jahaanb7/RadioTelescope/docs/gallery.md

# Rev C.2 CAD gallery

These five views are the user-supplied screenshots of the updated CAD, not photographs of a completed build. The ZIP also includes generated assembly-stage and part renders used throughout the assembly guide.

## Perspective

perspective CAD view

## Front

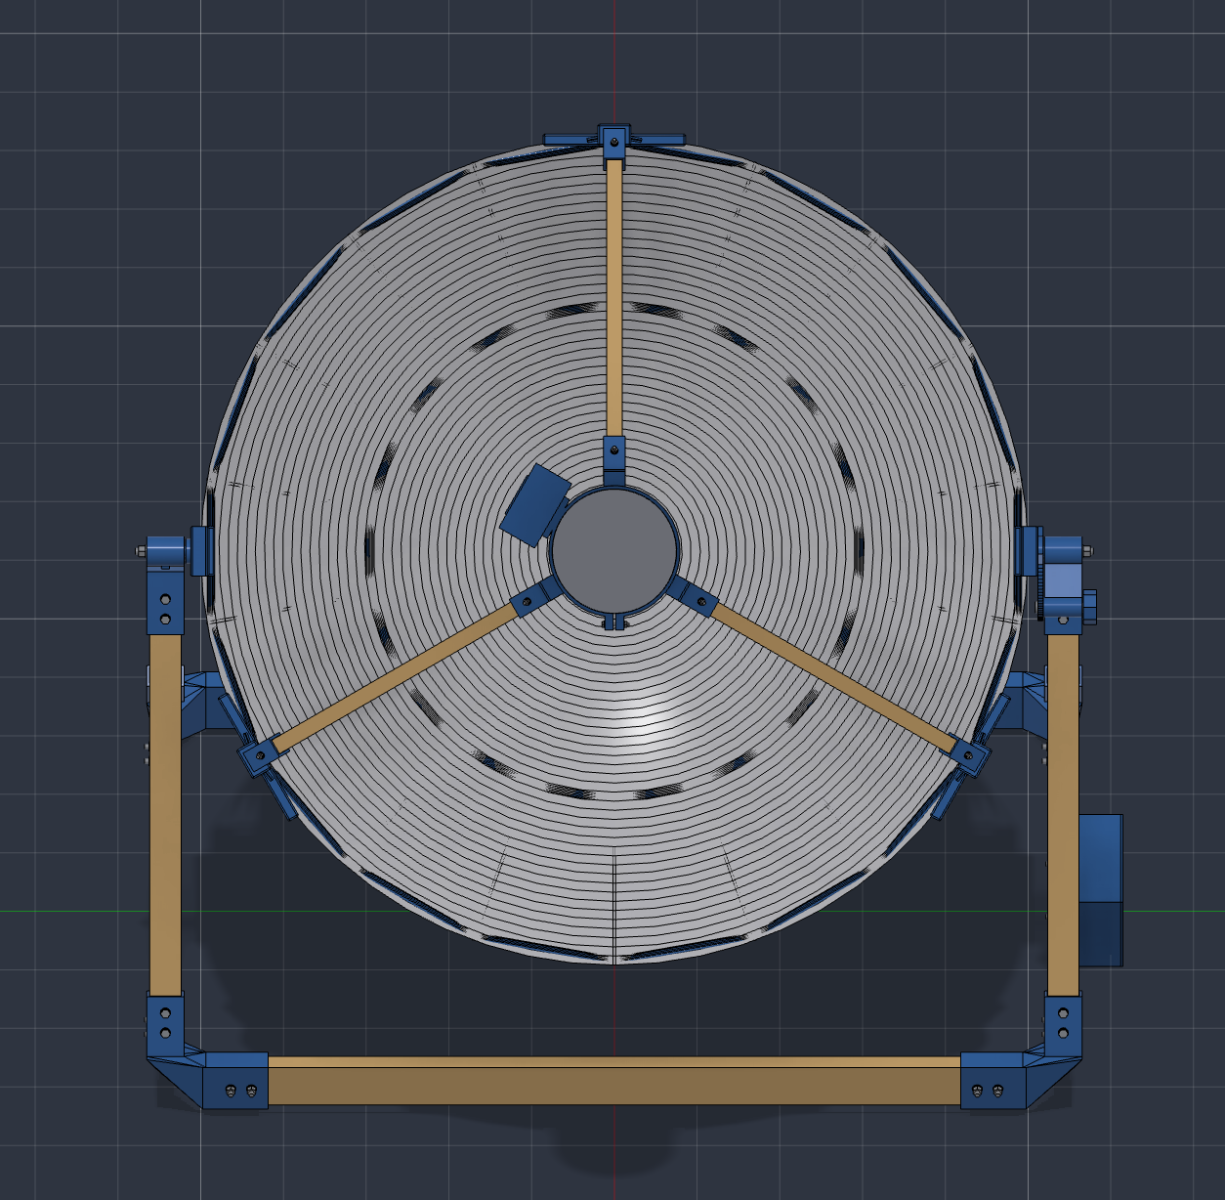
[picture p2: images/screenshots/front.png]
front CAD view


## Side

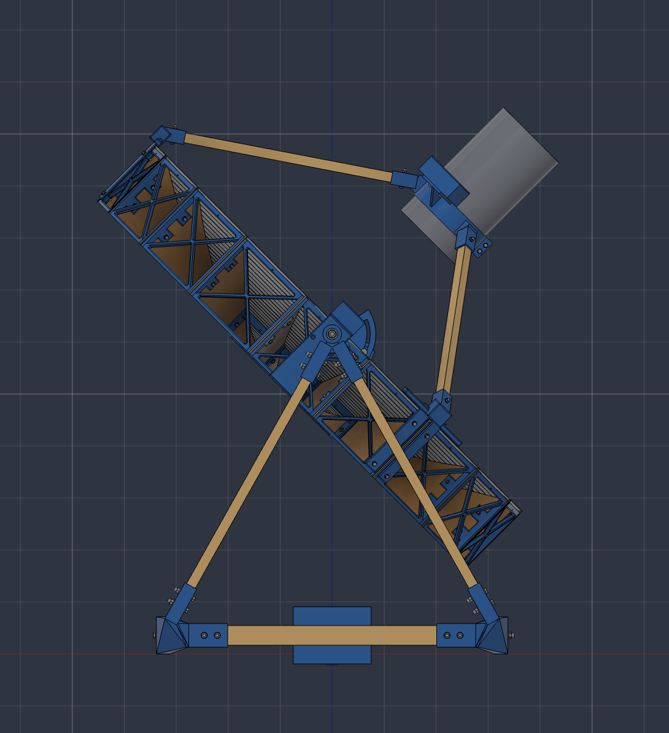
[picture p3: images/screenshots/side.png]
side CAD view


## Rear

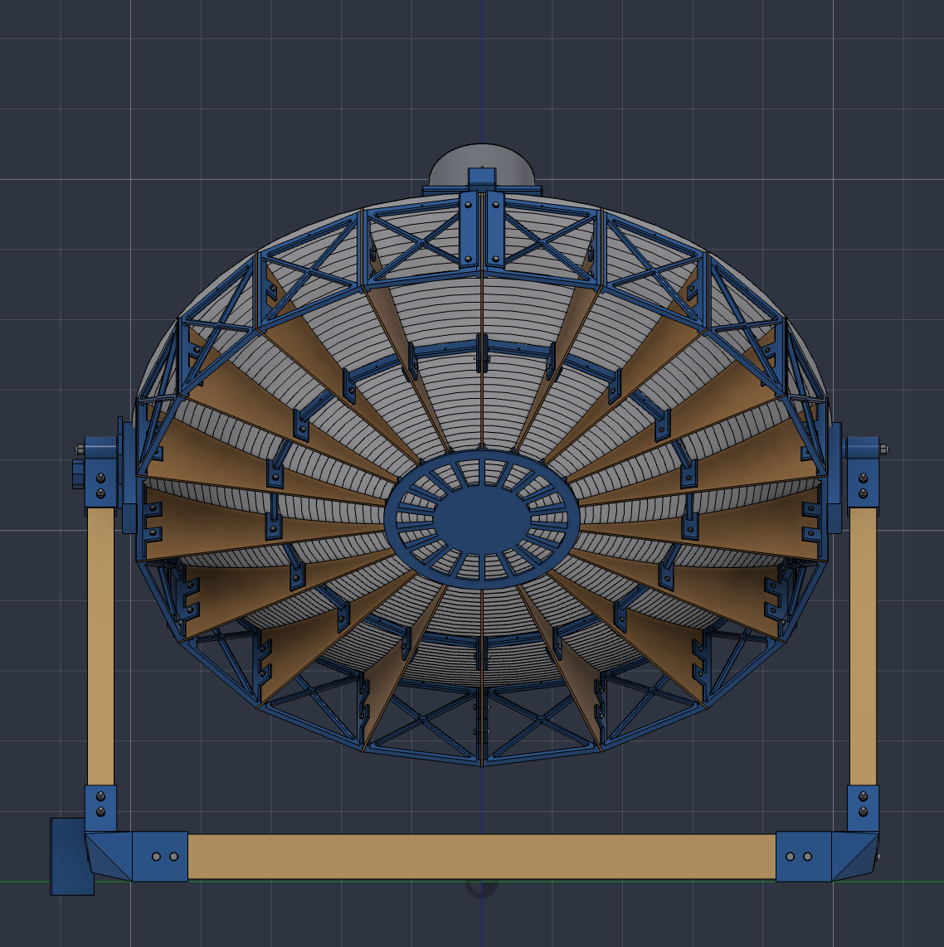
[picture p4: images/screenshots/rear.png]
rear CAD view


## Underside

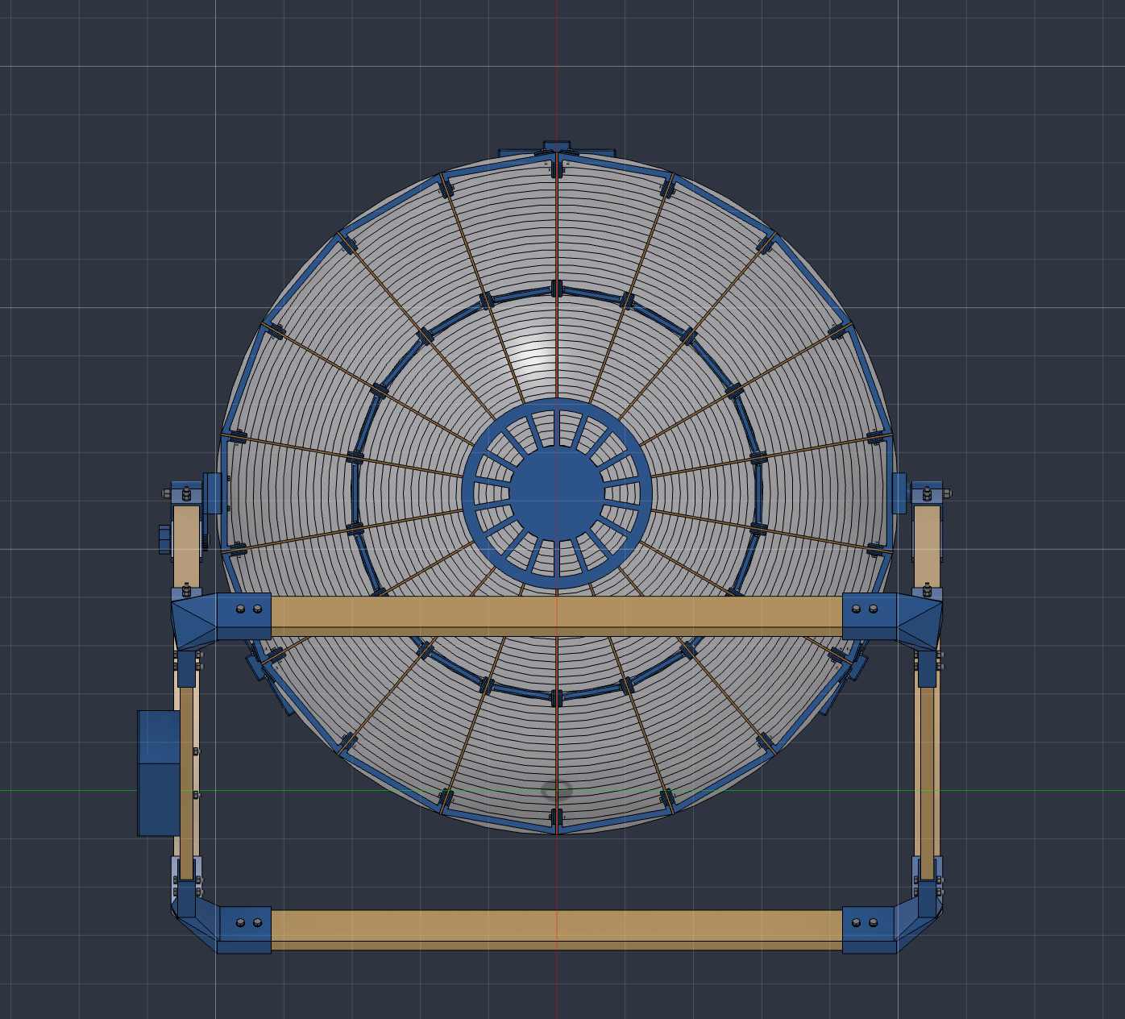
[picture p5: images/screenshots/underside.png]
underside CAD view


## Assembly stages

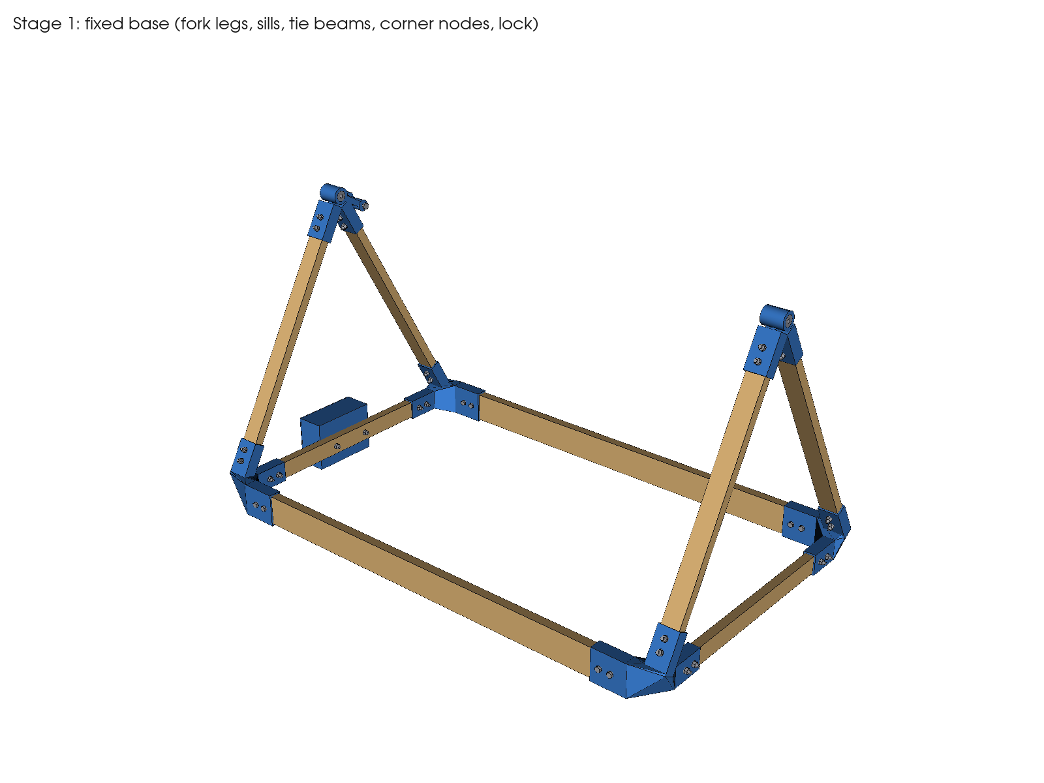
[picture p6: images/stage1_base.png]
Base and fork


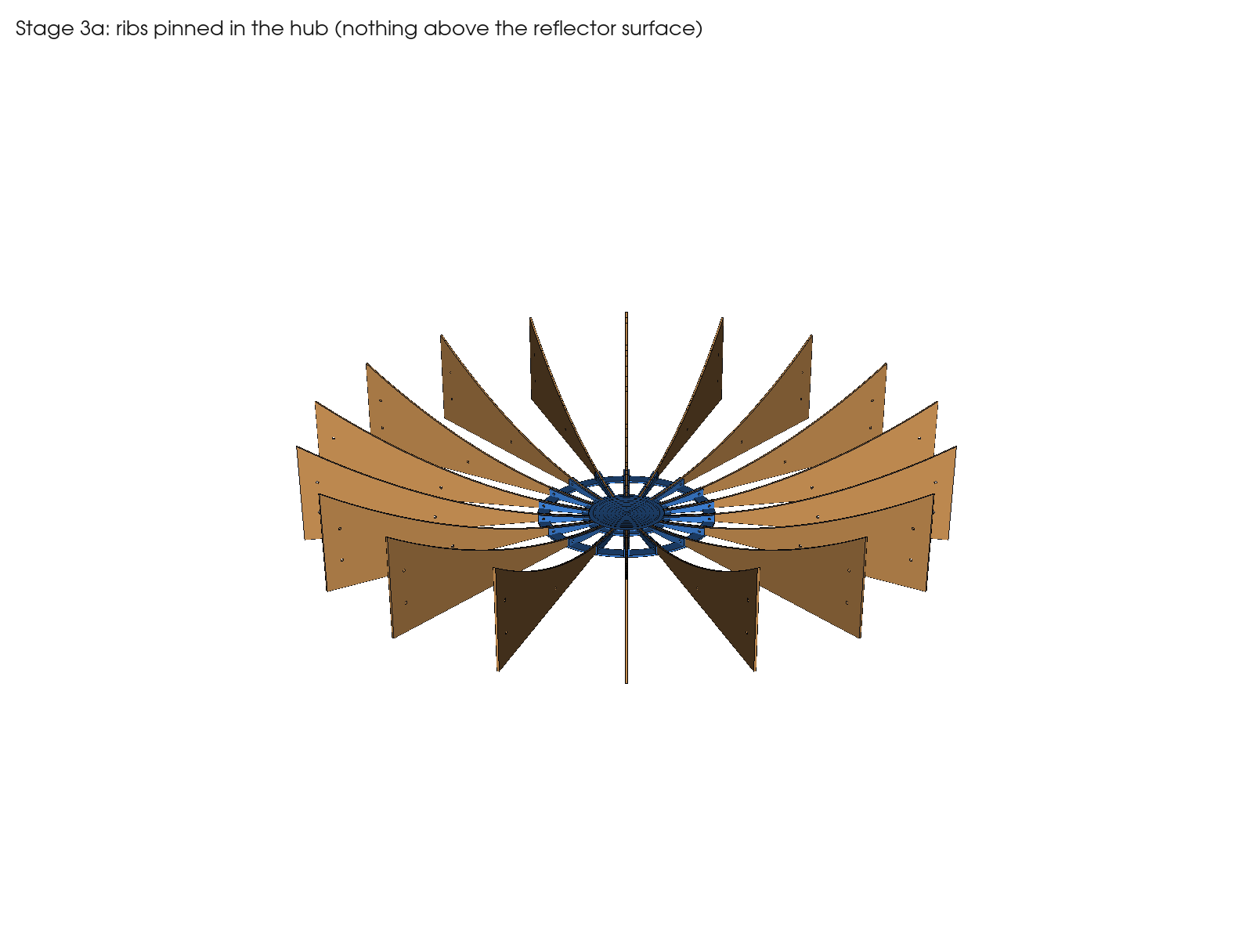
[picture p7: images/stage3a_ribs_hub.png]
Hub and ribs


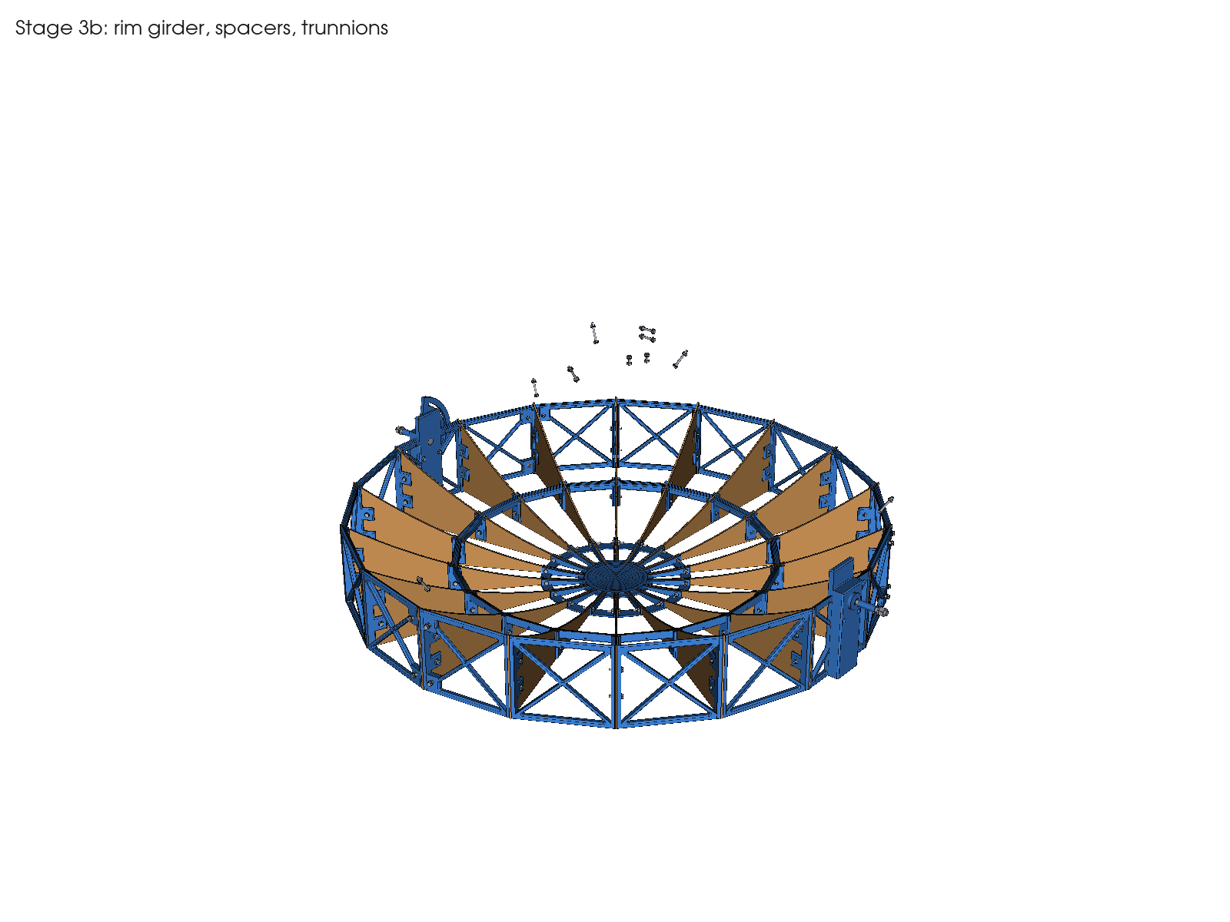
[picture p8: images/stage3b_dish_frame.png]
Dish frame


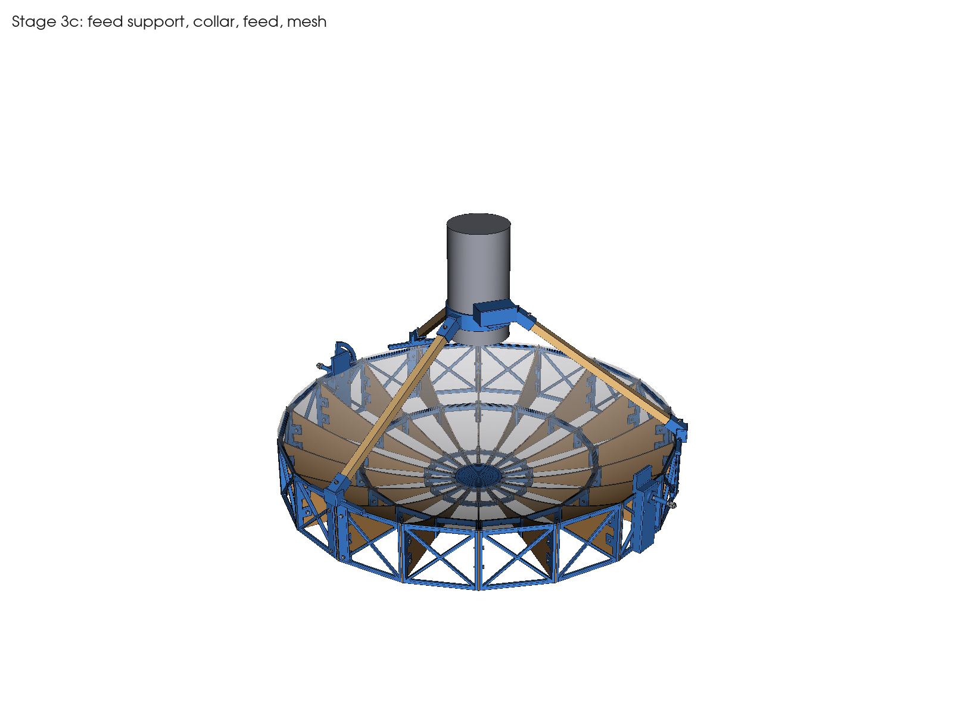
[picture p9: images/stage3c_dish_complete.png]
Feed and reflector
