jahaanb7/RadioTelescope/docs/inspection.md

# Build inspection record — Rev C.2

Use one copy per physical build. This is a proposed recording checklist, not evidence that any build has passed.

Build date: ____  CAD commit: ____  Builder: ____  Filament: ____

| Stage | Check | Measured result / notes | Pass / action |
|---|---|---|---|
| Inputs | Rib thickness and profile checked against the input register | | |
| Inputs | Batten sections and feed can measured; parameters updated | | |
| Printing | FIT-01 bearing, rib, socket and nut fits recorded | | |
| Base | Rectangle diagonals agree; four corners supported; fasteners seated | | |
| Fork | Bearing bores aligned; printed parts free of cracks | | |
| Ribs | Four structural holes per rib: two rim, one spacer, one hub pin | | |
| Dish | Ten RIM-01, six RIM-02, two opposite RIM-T; feed anchors correctly located | | |
| Axles | Spacer order matches guide; nuts retain axle without binding | | |
| Movement | Supported dish sweeps through range; lock holds; cables stay clear | | |
| Balance | Actual balance measured with receiver and cables fitted | | |
| Reflector | Mesh secured and profile inspected | | |
| RF | Feed, LNA, SDR, power and cable choices recorded before commissioning | | |

## If something does not fit

Record the part ID, measured dimensions, parameter values, filament and slicer settings, and a photograph. Update the source parameters and regenerate the affected build package. Do not treat a successful CAD interference check as a physical fit check.
