jahaanb7/RadioTelescope/images/motion_el60.png

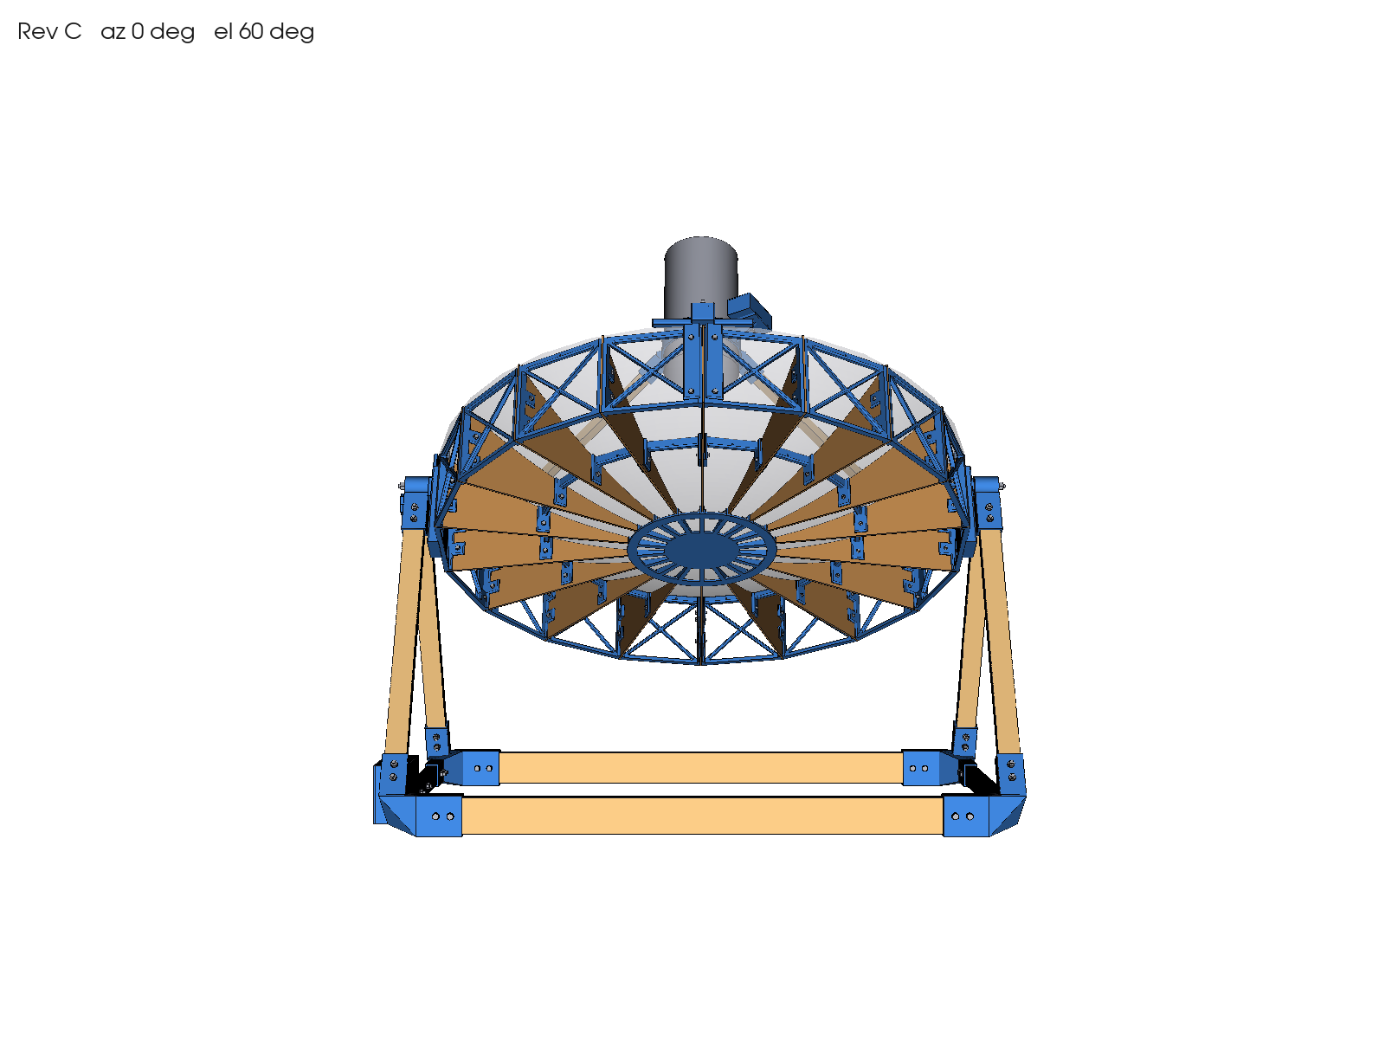
images/motion_el60.png
