jahaanb7/RadioTelescope/images/motion_el_minus5.png

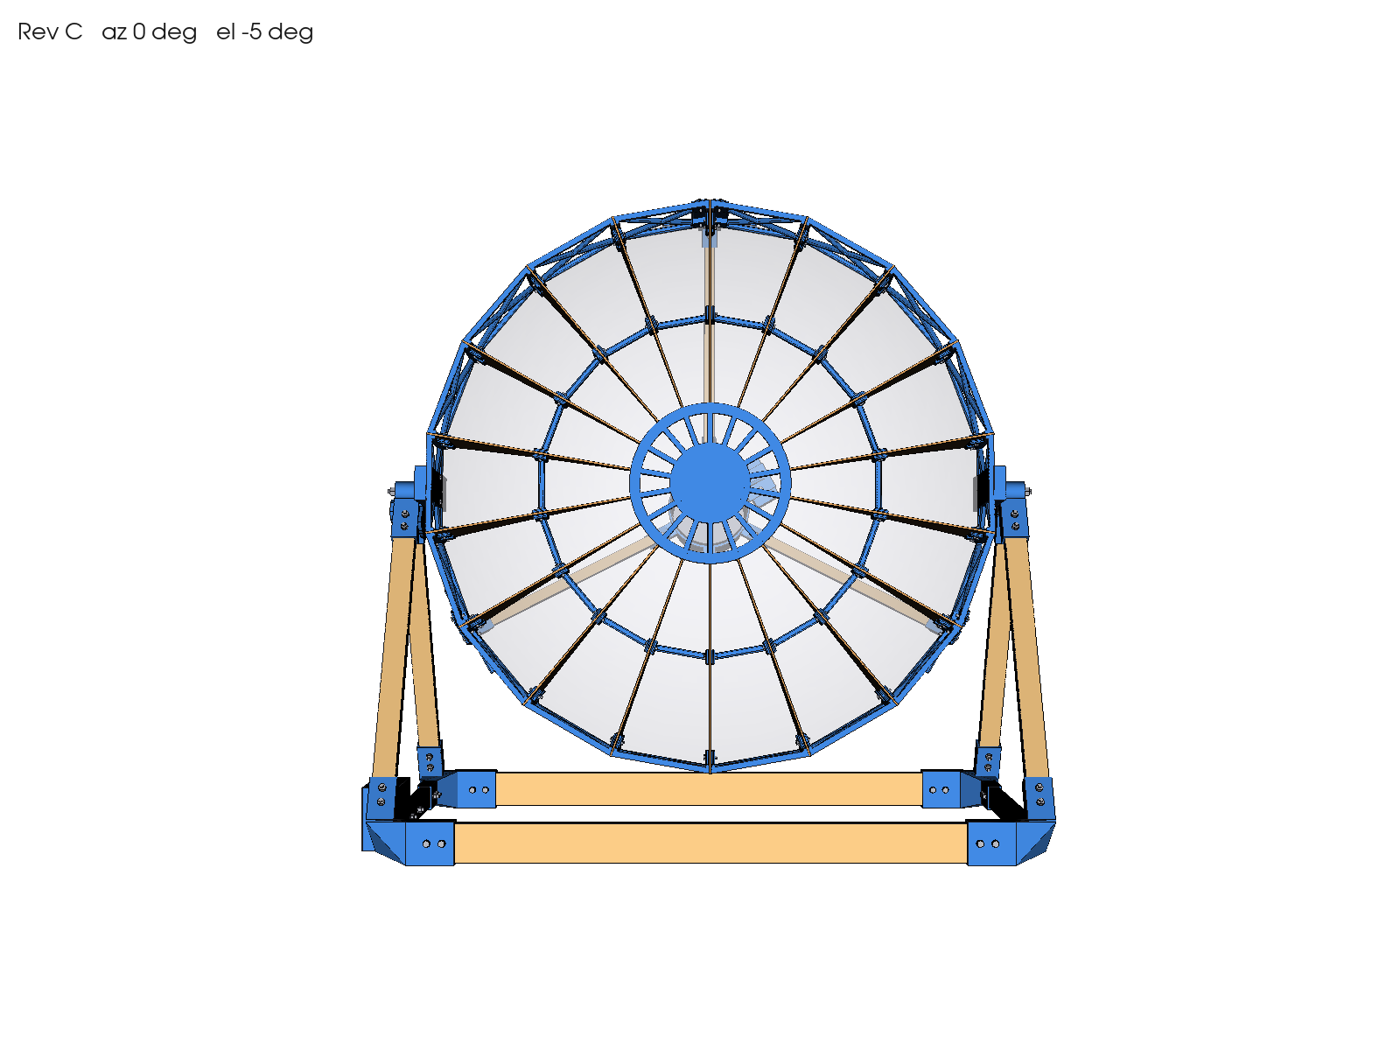
images/motion_el_minus5.png
