jahaanb7/RadioTelescope/docs/shopping_list.md

# Shopping list: everything you need to build Rev C.2

Quantities come from the model (`bom/bom.csv`, `bom/hardware.csv`, `bom/cut_list.csv`), and the fasteners
include about 10 % spare.

**[View the priced BOM and total cost](../bom/README.md).** The reference budget is **CAD $510.57 for the mechanical build** or **CAD $1,232.93 including provisional RF and computing hardware**, before tax and shipping. The cost sheet provides unit prices, extended totals, sources, estimate labels and deductions for existing equipment. This page retains the material specifications and cutting notes.

## 1. Materials

| Item | Quantity | Notes |
|---|---|---|
| PETG filament, 1.75 mm | **7 × 1 kg spools** | The parts use about 5.35 kg (estimate in the supplied Rev C.2 README; verify in your slicer), plus spare for failed prints. Use one brand and colour throughout, so the fit coupon is valid for every part |
| 1/8 in (3.2 mm) plywood ribs | 18, already cut | Your existing ribs. Cut the tip relief and drill four 4.5 mm holes each (`bom/rib_modifications.csv`) |
| 1x2 softwood batten (actual 19 × 38 mm) | **2 × 8 ft** (2.44 m) | Board 1: 4 × `LEG-A` at 601 mm. Board 2: 2 × `SIL-01` at 548 mm |
| 1x3 softwood batten (actual 19 × 64 mm) | **1 × 8 ft** | 2 × `TIE-01` at 983 mm |
| 3/4 in square softwood (19 × 19 mm) | **1 × 6 ft** (1.83 m) | 3 × `LEG-F` at 492 mm |
| Reflector mesh: galvanised hardware cloth or aluminium mesh, 6 mm (1/4 in) openings or finer | **about 1.2 × 1.2 m** (the dish surface is 0.86 m²) | Openings must stay under 21 mm (a tenth of the 21 cm wavelength); 1/4 in is a good choice. Aluminium is lighter |
| Feed can: metal can, about 150 mm diameter × 280 mm long, one closed end | 1 | A coffee or paint can works. Measure it and put the size in `parameters.yaml` before printing `FRG-01` |
| Exterior wood sealer or varnish | small tin | For the batten ends and faces |
| Zip ties, 2.5 mm wide UV-resistant, or stainless wire | about 300 | For fastening the mesh to the ribs |

Batten tip: look for straight, knot-free pieces, and sight along each board before buying. Cut lengths are exact,
with 3 mm of saw kerf allowed for between pieces.

## 2. Bought mechanical parts

| Item | Quantity | Used in |
|---|---|---|
| 608-2RS ball bearing (8 × 22 × 7 mm, skateboard size) | 4, plus 1 spare | Fork top nodes `FKT-01` and `FKT-02` |

## 3. Fasteners (zinc-plated steel, grade 8.8)

From `bom/hardware.csv`; "Buy" adds about 10 %.

| Item | Count in model | Buy |
|---|---:|---:|
| M4 nut | 96 | 106 |
| M4 washer | 86 | 95 |
| M4 x 12 bolt | 2 | 3 |
| M4 x 20 bolt | 84 | 93 |
| M4 x 30 bolt | 2 | 3 |
| M4 x 35 bolt | 8 | 9 |
| M6 nut | 35 | 39 |
| M6 washer | 69 | 76 |
| M6 x 35 bolt | 2 | 3 |
| M6 x 40 bolt | 32 | 36 |
| M6 x 70 carriage bolt, elevation lock | 1 | 2 |
| M8 nyloc nut | 2 | 3 |
| M8 washer | 2 | 3 |
| M8 x 90 elevation axle bolt | 2 | 3 |

Boxed assortments of M4 and M6 bolts are usually cheaper than buying them loose.

## 4. Electronics (not designed yet; listed so nothing is forgotten)

| Item | Notes |
|---|---|
| Low-noise amplifier (LNA) for 1420 MHz, with a filter | Fits in `LNA-01`; the box is an envelope, so check the size |
| SDR receiver (for example an RTL-SDR or Airspy class) | In `EBOX-01` |
| Raspberry Pi 5, power supply, SSD | In `EBOX-01` |
| Coax: a short lead from the probe to the LNA, then about 3 m to the box | Leave a loop at the elevation axle |
| Feed probe: a quarter-wave monopole made from brass rod and an N or SMA panel connector | The position in the can must be set from the can's measured size |

## 5. Ballast and tools

- **Ballast:** four sandbags or water jugs, up to 4 kg each, laid over the tie-beam ends in wind.
- **Tools:**
  - drill with 2.5, 4.5 and 6.5 mm bits;
  - saw with a mitre box;
  - 7, 10 and 13 mm spanners;
  - calipers, square and spirit level;
  - vice (for pressing the bearings);
  - soldering iron (for setting nuts in the printed pockets);
  - tin snips (for cutting the mesh).
