jahaanb7/RadioTelescope/bom/bom.csv

part | name | kind | material | group | qty | kg_each | kg_total
RIB | existing rib | existing | plywood | dish | 18 | 0.049 | 0.888
HUB-01 | hub with 18 rib channels and tip pins | print | petg | dish | 1 | 0.221 | 0.221
RIM-01 | rim girder bay | print | petg | dish | 10 | 0.093 | 0.926
RIM-02 | feed rim bay 50 deg (anchor pads) | print | petg | dish | 6 | 0.096 | 0.578
RIM-T | rim girder trunnion bay | print | petg | dish | 2 | 0.234 | 0.468
SPC-01 | mid-span spacer bay | print | petg | dish | 18 | 0.025 | 0.456
FLA-01 | feed-leg anchor | print | petg | dish | 3 | 0.097 | 0.292
LEG-F | feed leg | wood | softwood | dish | 3 | 0.080 | 0.239
FRG-01 | feed collar (split, three leg sockets, LNA shelf) | print | petg | dish | 1 | 0.206 | 0.206
FEED-01 | feed can (conductive, provisional size) | purchase | steel | dish | 1 | 0.400 | 0.400
LNA-01 | LNA enclosure body (envelope for the chosen LNA) | print | petg | dish | 1 | 0.120 | 0.120
LNA-02 | LNA enclosure lid | print | petg | dish | 1 | 0.024 | 0.024
ELS-01 | elevation lock sector (+Y trunnion) | print | petg | dish | 1 | 0.055 | 0.055
SPR-03 | axle spacer, -Y trunnion (replaces the sector thickness) | print | petg | dish | 1 | 0.005 | 0.005
SPR-01 | axle spacer between sector and inner bearing | print | petg | dish | 2 | 0.000 | 0.000
SPR-02 | axle spacer between the two bearings | print | petg | dish | 2 | 0.002 | 0.005
MESH-01 | reflector mesh, representative ideal surface | purchase | mesh | dish | 1 | 0.575 | 0.575
FKT-01 | fork top node +Y (fixed bearing fit, lock lug) | print | petg | az | 1 | 0.152 | 0.152
BRG-608 | 608 ball bearing 8 x 22 x 7 | purchase | steel | az | 4 | 0.012 | 0.048
FKT-02 | fork top node -Y (floating bearing fit) | print | petg | az | 1 | 0.126 | 0.126
KNB-01 | elevation lock knob (captures an M6 nut) | print | petg | az | 1 | 0.014 | 0.014
FKC-01 | base corner node x+ y+ | print | petg | az | 2 | 0.226 | 0.451
FKC-02 | base corner node x+ y- | print | petg | az | 2 | 0.226 | 0.451
LEG-A | fork leg x+ y+ | wood | softwood | az | 4 | 0.194 | 0.776
TIE-01 | base tie x+ | wood | softwood | az | 2 | 0.537 | 1.074
SIL-01 | base sill y+ | wood | softwood | az | 2 | 0.176 | 0.353
EBOX-01 | electronics enclosure body (envelope: Pi 5, SDR, SSD) | print | petg | az | 1 | 0.900 | 0.900
EBOX-02 | electronics enclosure lid | print | petg | az | 1 | 0.089 | 0.089
