jahaanb7/RadioTelescope/bom/cut_list.csv

part | name | section_mm | length_mm | qty | bolt_holes_from_each_end_mm | hole_dia_mm | drill_through
LEG-A | fork leg x+ y+ | 19 x 38 | 601 | 4 | 28 / 53 | 6.5 | through the 19 mm face, centred on the 38 mm width
SIL-01 | base sill y+ | 19 x 38 | 548 | 2 | 28 / 53 | 6.5 | through the 19 mm face, centred on the 38 mm width
TIE-01 | base tie x+ | 19 x 64 | 983 | 2 | 28 / 53 | 6.5 | through the 19 mm face, centred on the 64 mm width
LEG-F | feed leg | 19 x 19 | 492 | 3 | 21 | 4.5 | through the 19 mm face, centred on the 19 mm width
NOTE | Cut lengths are exact; the sockets leave 2 mm at each end. Square cuts.
