jahaanb7/RadioTelescope/images/parts/EBOX-01.png

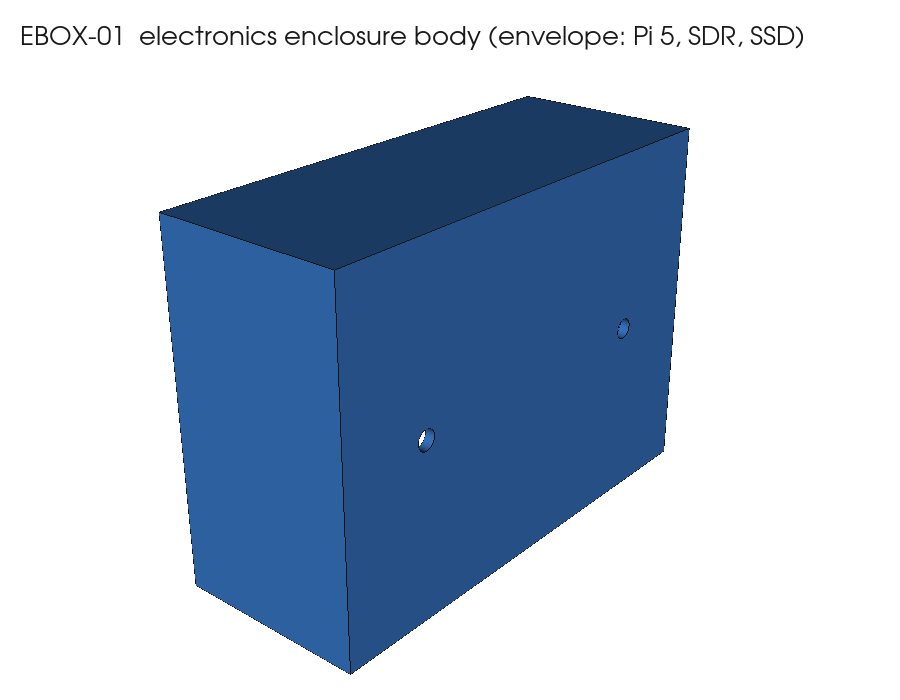
images/parts/EBOX-01.png
