jahaanb7/RadioTelescope/images/parts/EBOX-02.png

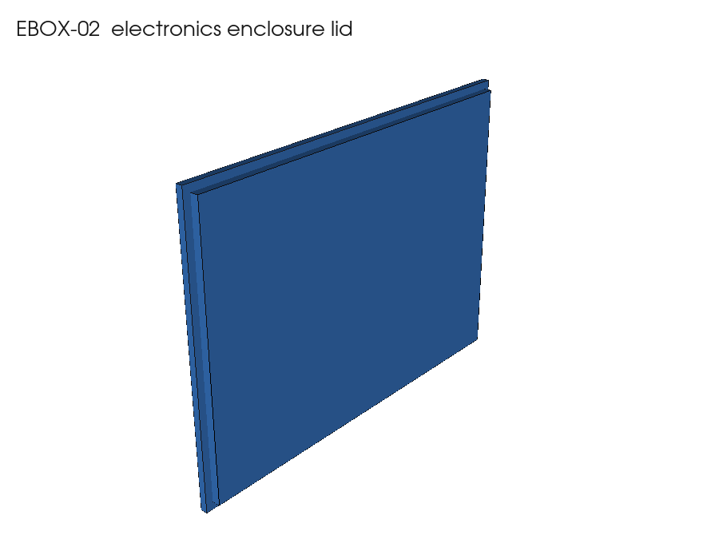
images/parts/EBOX-02.png
