jahaanb7/RadioTelescope/images/parts/ELS-01.png

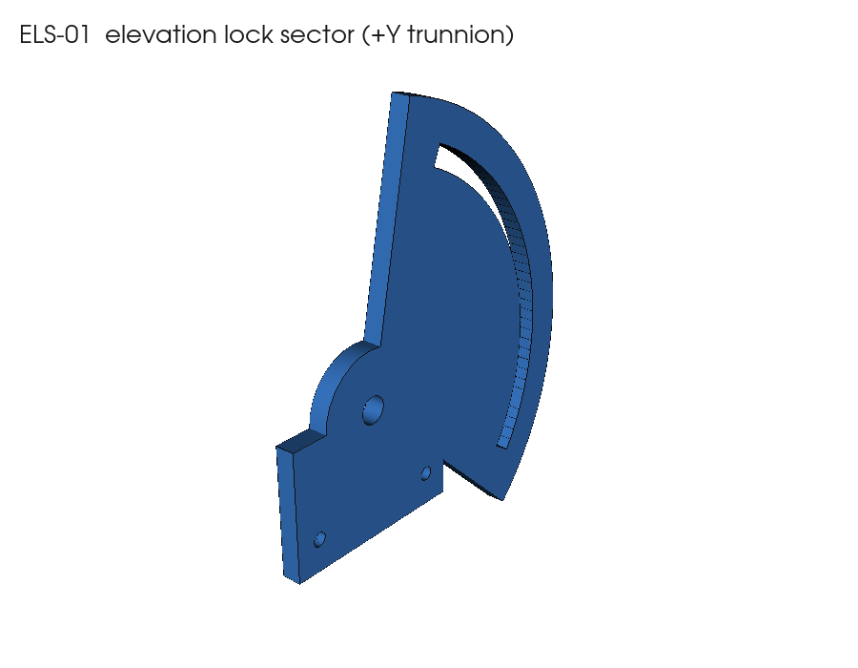
images/parts/ELS-01.png
