jahaanb7/RadioTelescope/images/parts/FIT-01.png

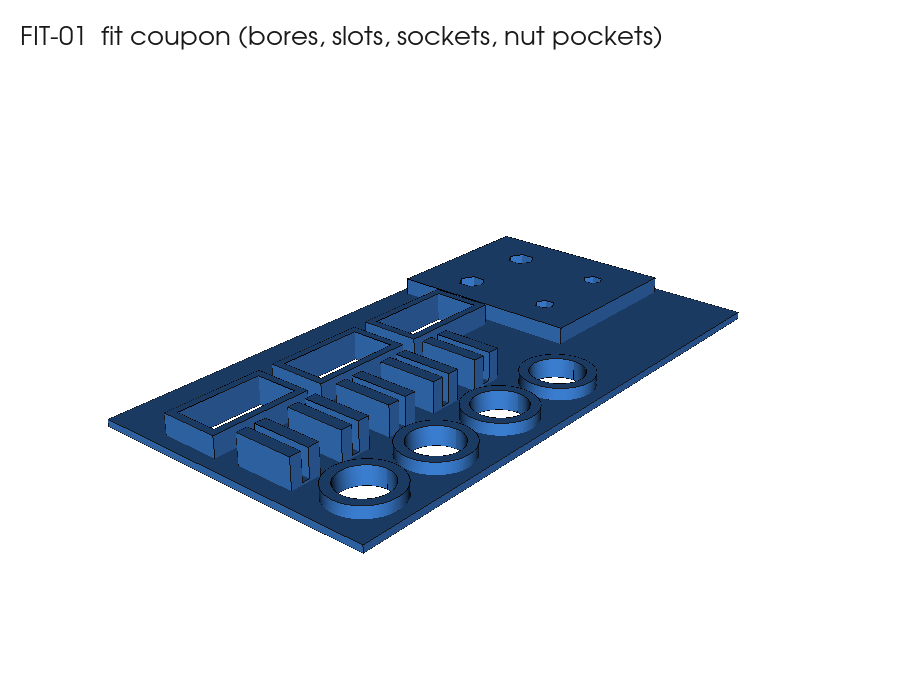
images/parts/FIT-01.png
