jahaanb7/RadioTelescope/images/parts/FKC-01.png

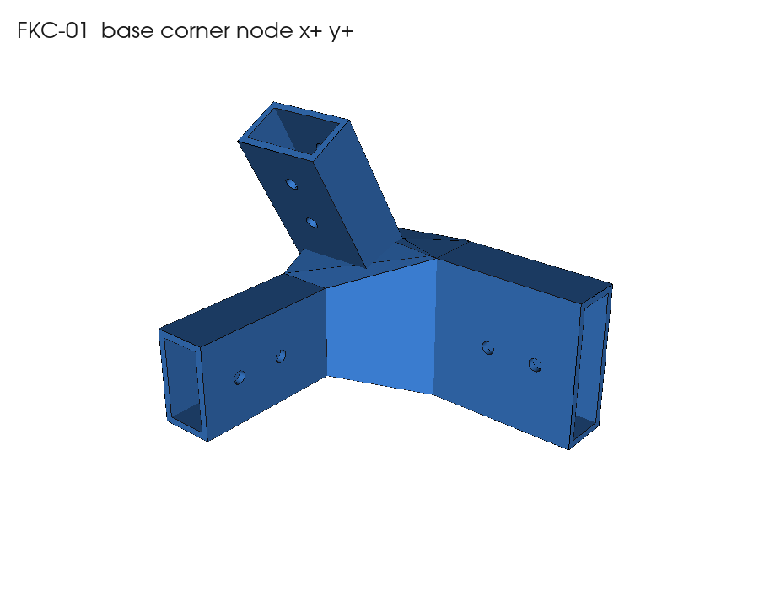
images/parts/FKC-01.png
