jahaanb7/RadioTelescope/images/parts/FKC-02.png

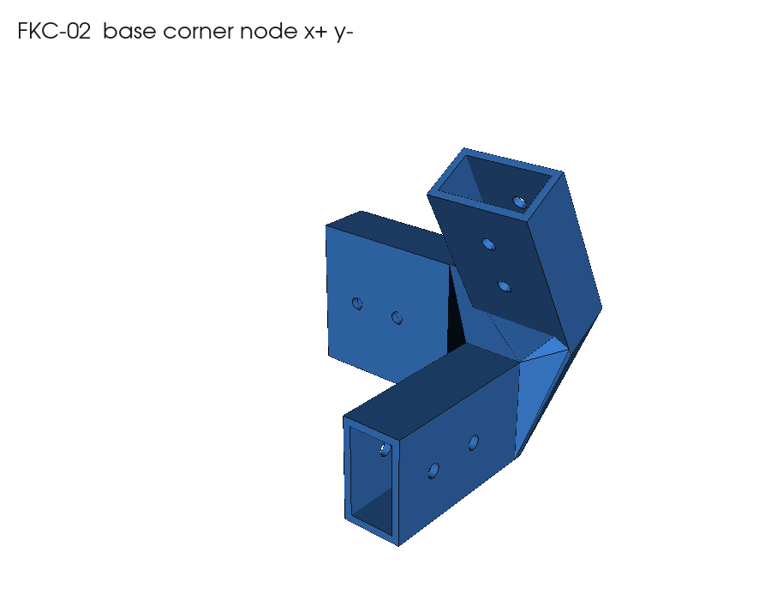
images/parts/FKC-02.png
