jahaanb7/RadioTelescope/images/parts/FKT-01.png

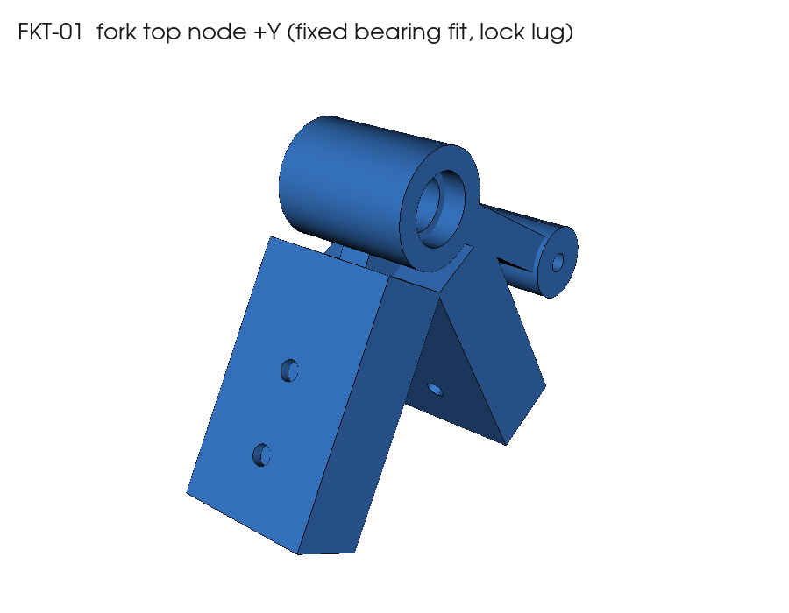
images/parts/FKT-01.png
