jahaanb7/RadioTelescope/images/parts/FLA-01.png

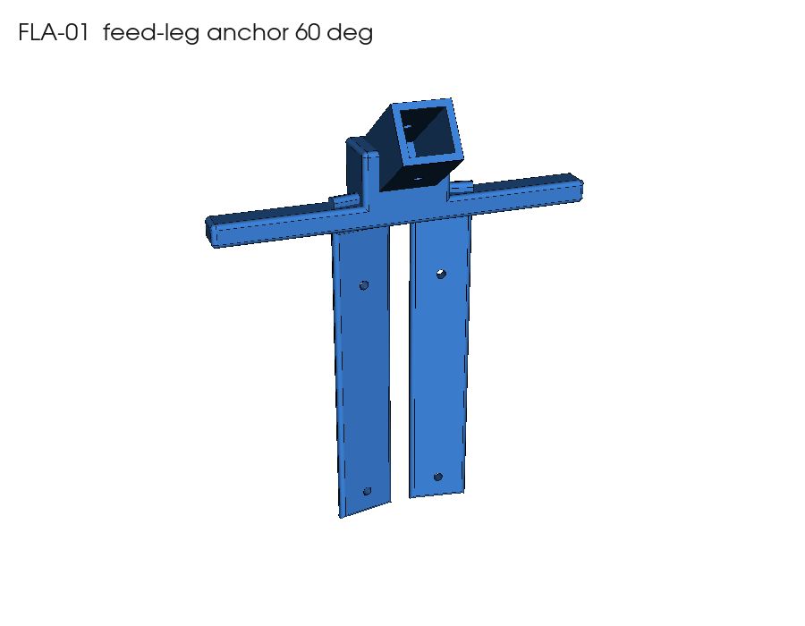
images/parts/FLA-01.png
