jahaanb7/RadioTelescope/images/parts/FRG-01.png

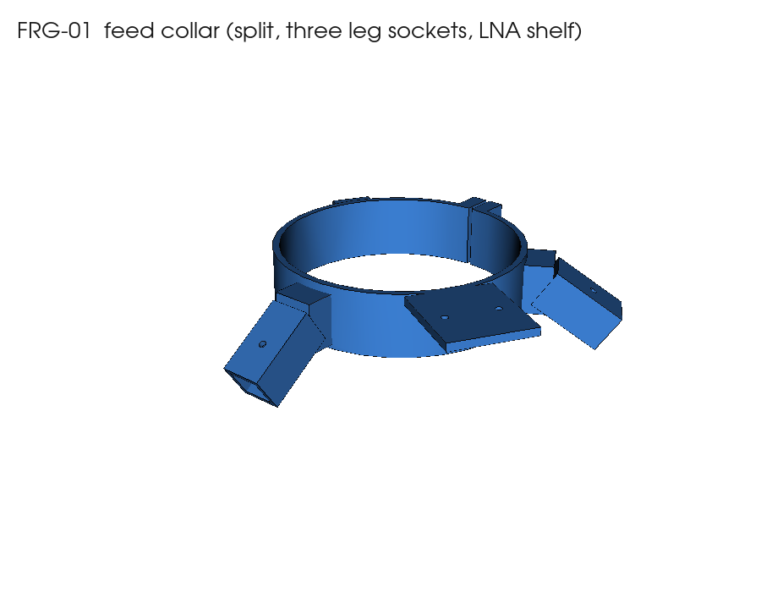
images/parts/FRG-01.png
