jahaanb7/RadioTelescope/images/parts/HUB-01.png

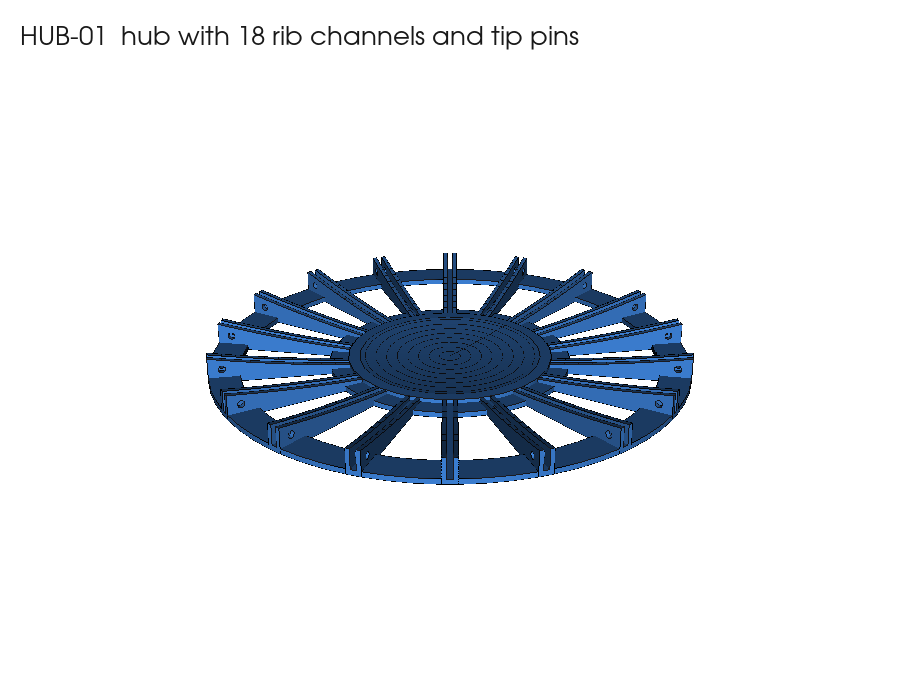
images/parts/HUB-01.png
