jahaanb7/RadioTelescope/images/parts/JIG-01.png

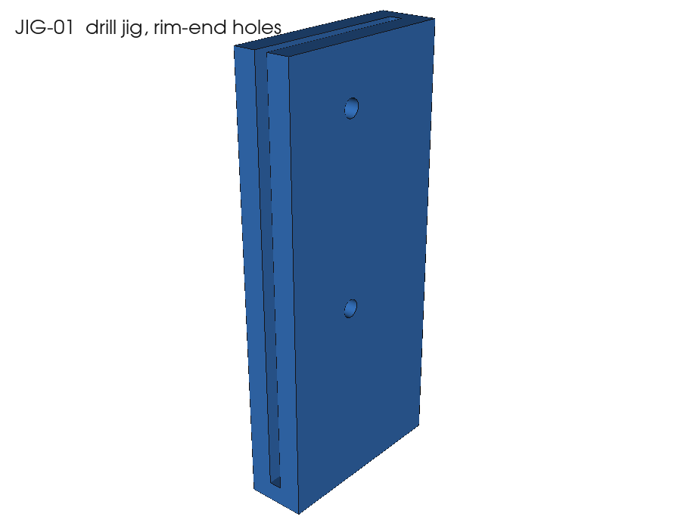
images/parts/JIG-01.png
