jahaanb7/RadioTelescope/images/parts/JIG-02.png

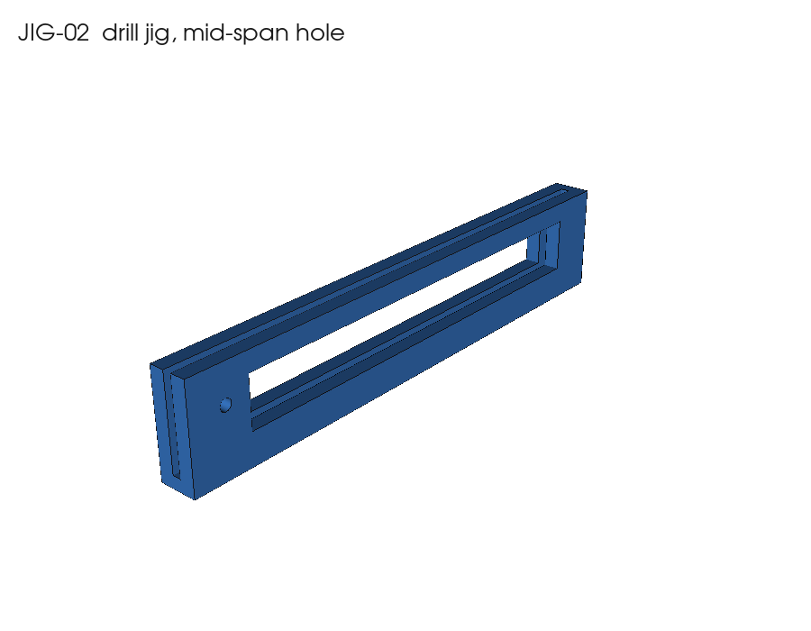
images/parts/JIG-02.png
