jahaanb7/RadioTelescope/images/parts/KNB-01.png

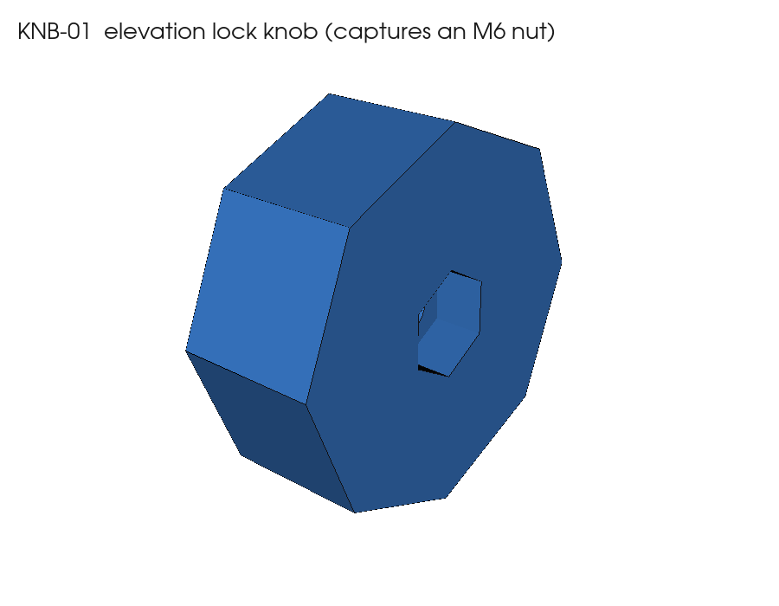
images/parts/KNB-01.png
