jahaanb7/RadioTelescope/images/parts/LEG-A.png

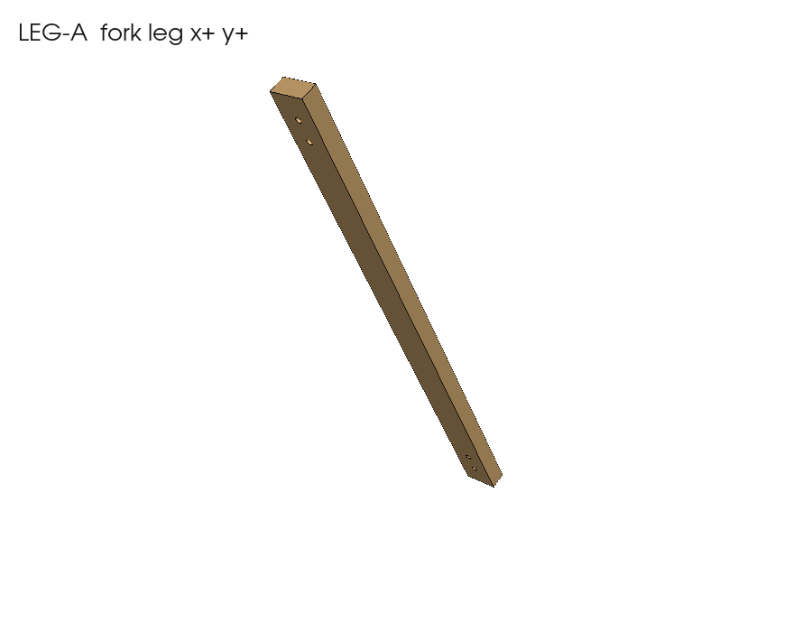
images/parts/LEG-A.png
