jahaanb7/RadioTelescope/images/parts/LEG-F.png

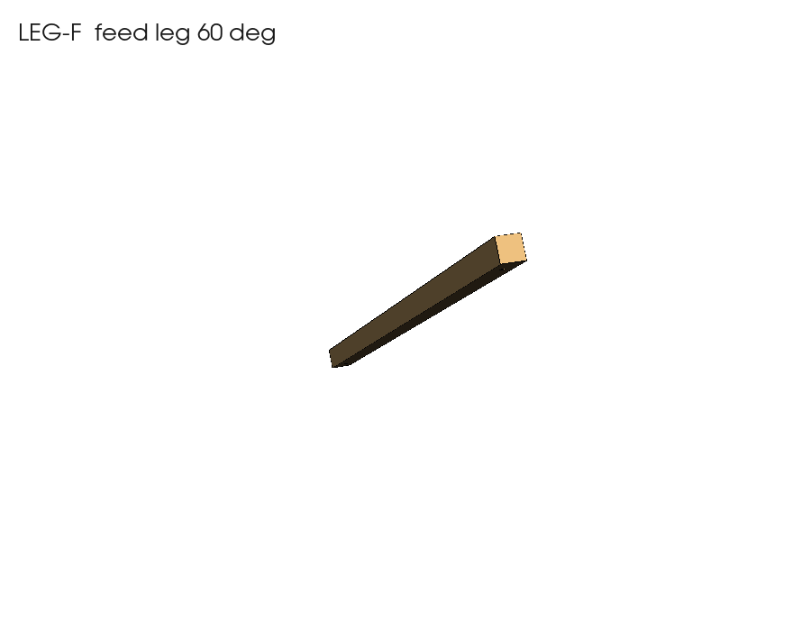
images/parts/LEG-F.png
