jahaanb7/RadioTelescope/images/parts/LNA-01.png

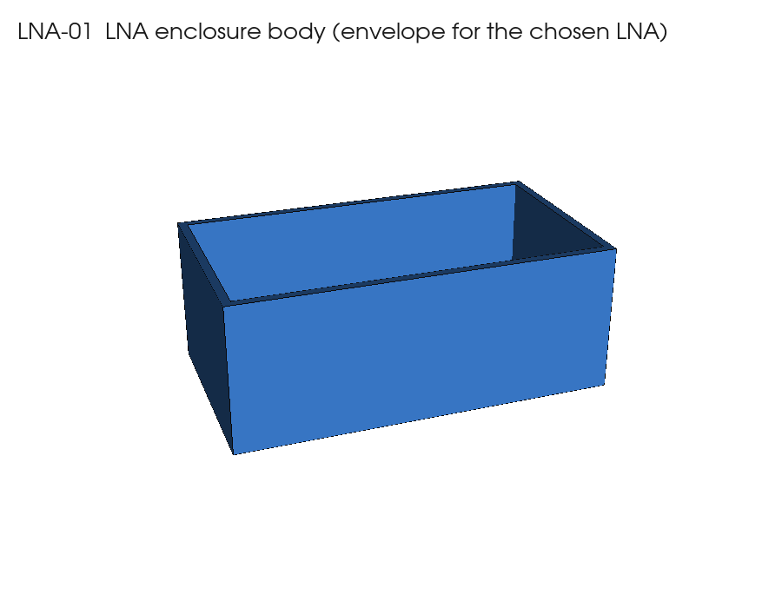
images/parts/LNA-01.png
