jahaanb7/RadioTelescope/images/parts/LNA-02.png

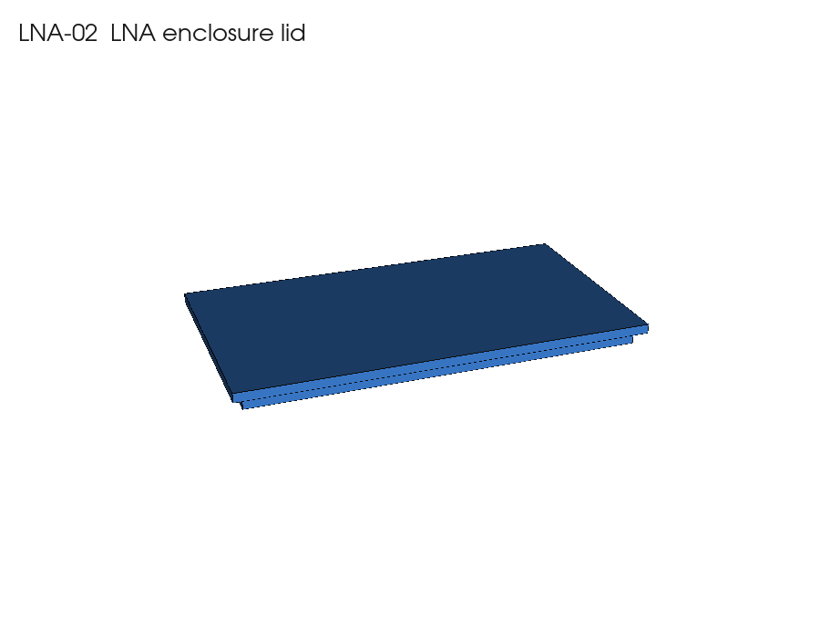
images/parts/LNA-02.png
