jahaanb7/RadioTelescope/images/parts/RIM-01.png

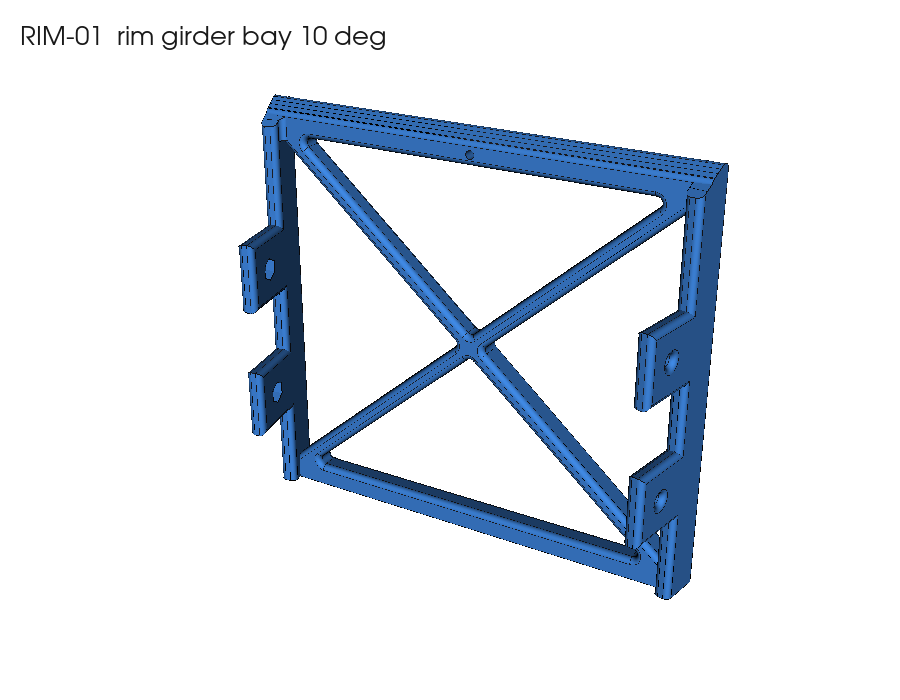
images/parts/RIM-01.png
