jahaanb7/RadioTelescope/images/parts/RIM-02.png

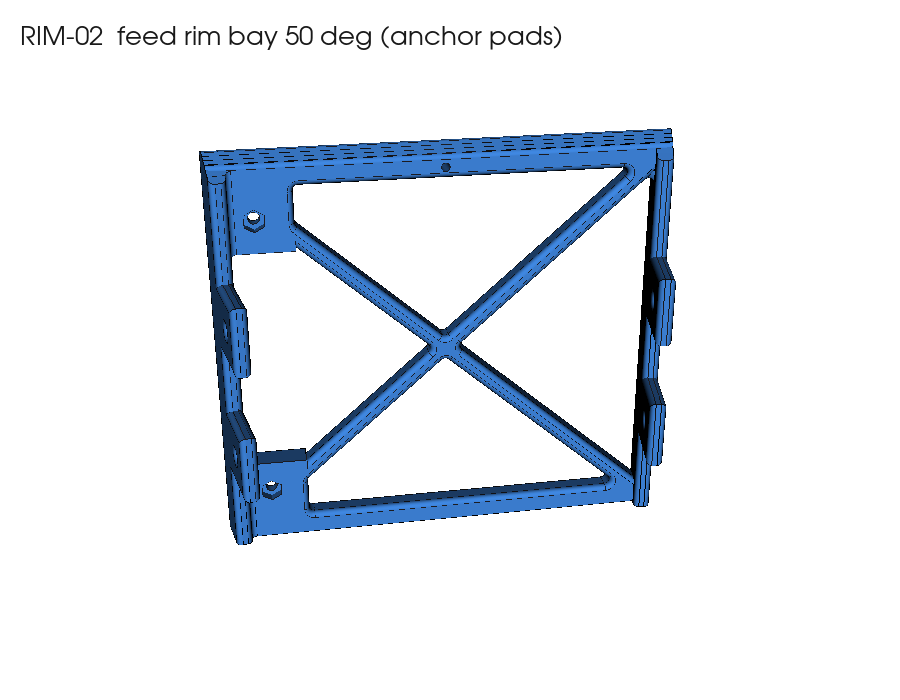
images/parts/RIM-02.png
