jahaanb7/RadioTelescope/images/parts/RIM-T.png

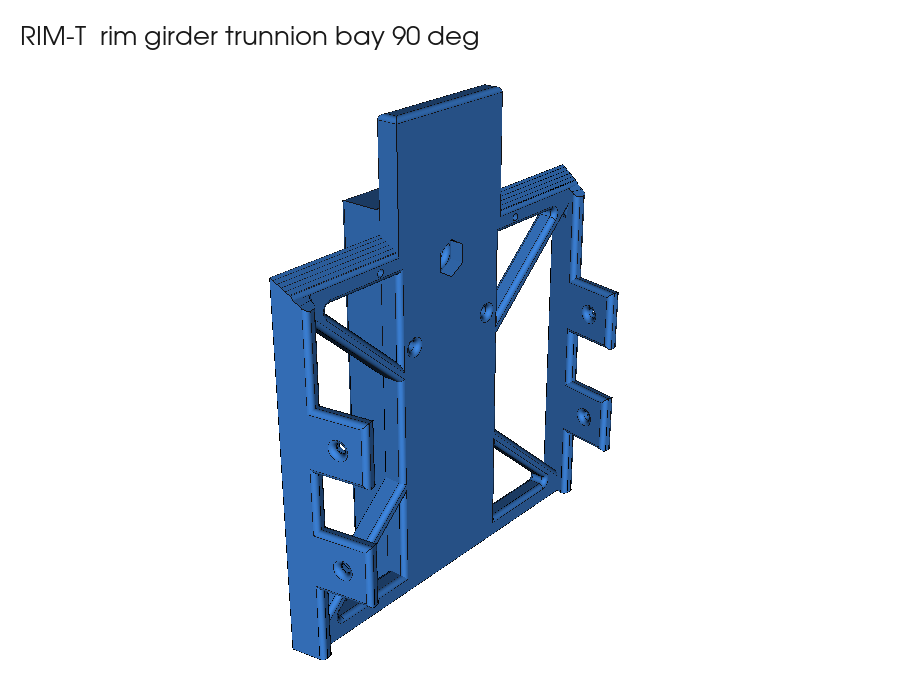
images/parts/RIM-T.png
