jahaanb7/RadioTelescope/images/parts/SIL-01.png

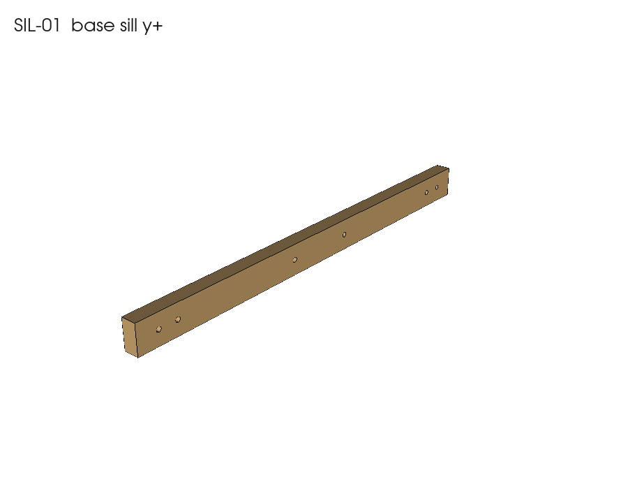
images/parts/SIL-01.png
