jahaanb7/RadioTelescope/images/parts/SPC-01.png

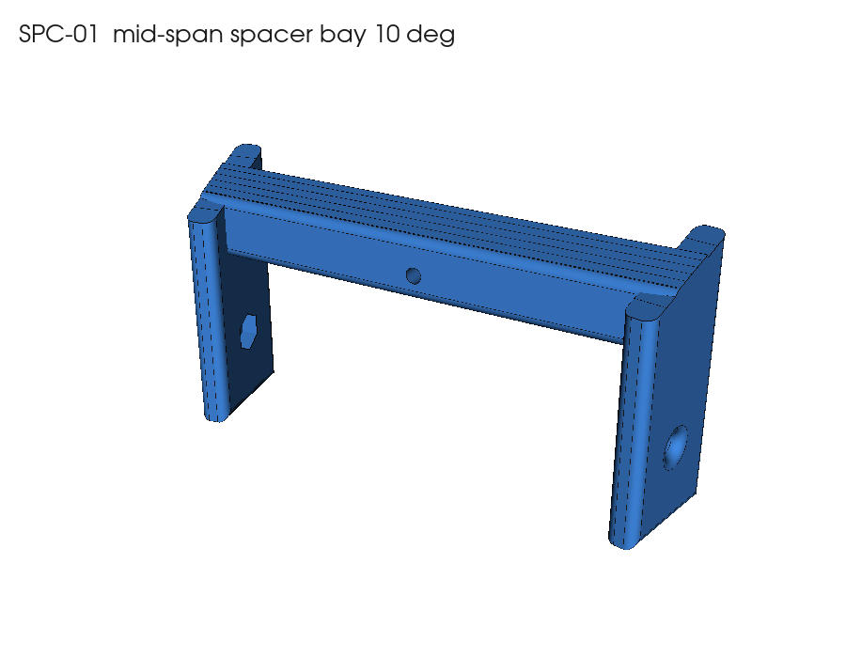
images/parts/SPC-01.png
