jahaanb7/RadioTelescope/images/parts/SPR-01.png

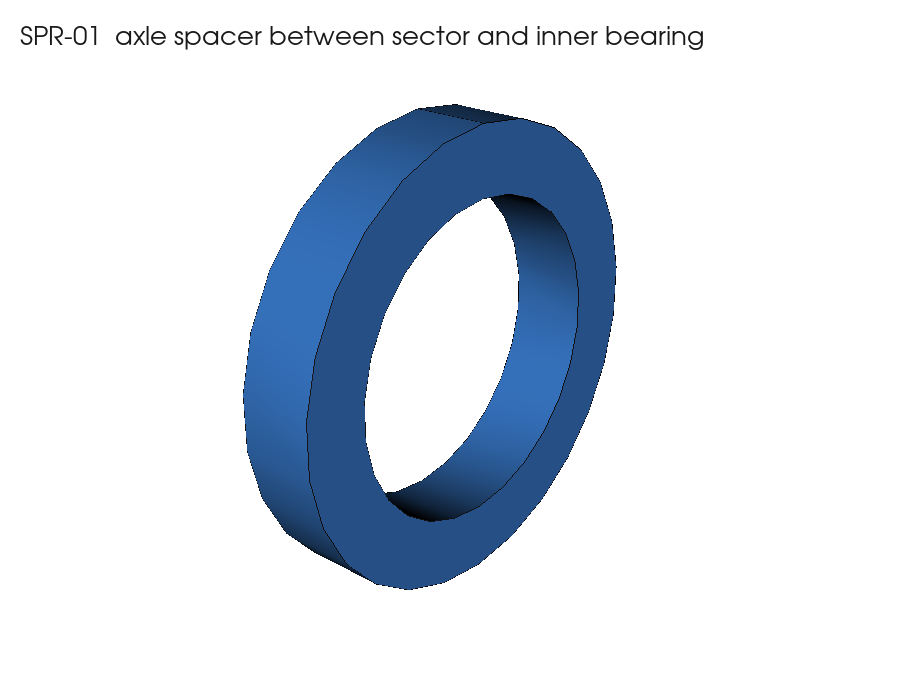
images/parts/SPR-01.png
