jahaanb7/RadioTelescope/images/parts/SPR-02.png

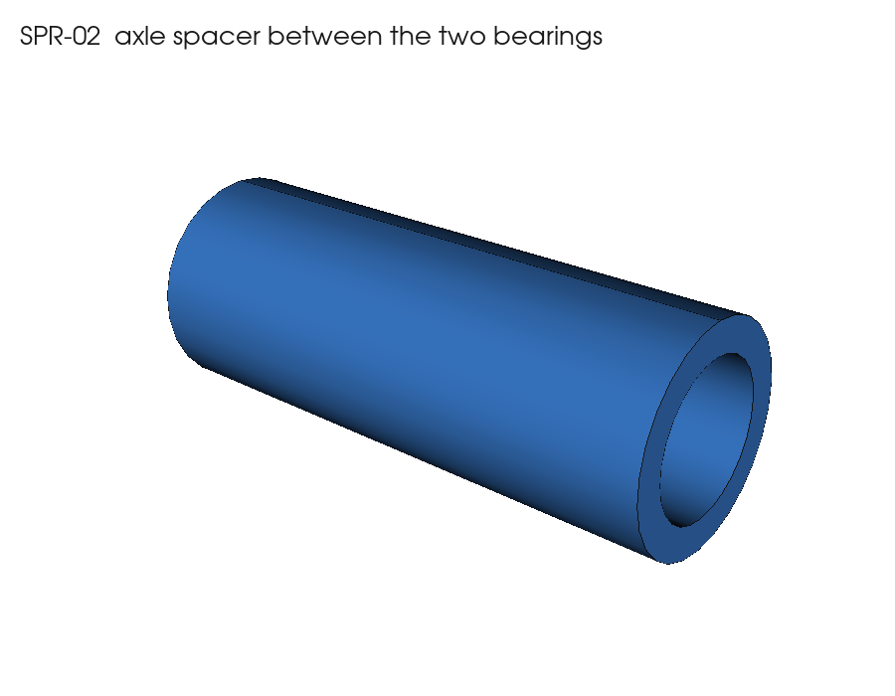
images/parts/SPR-02.png
