jahaanb7/RadioTelescope/images/parts/SPR-03.png

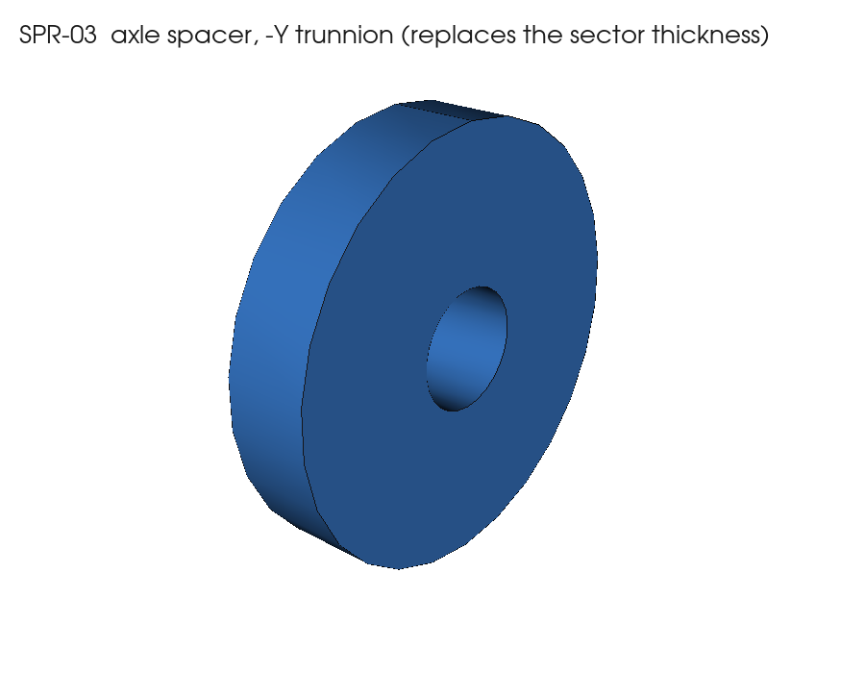
images/parts/SPR-03.png
