jahaanb7/RadioTelescope/images/parts/TIE-01.png

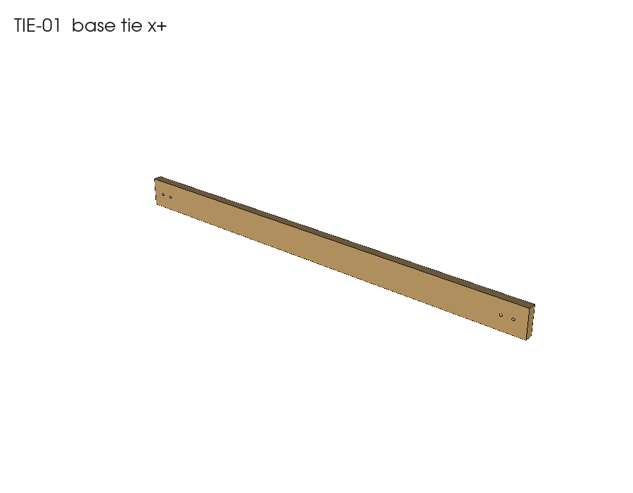
images/parts/TIE-01.png
