jahaanb7/RadioTelescope/drawings/RIB_drilling_template_1to1.dxf

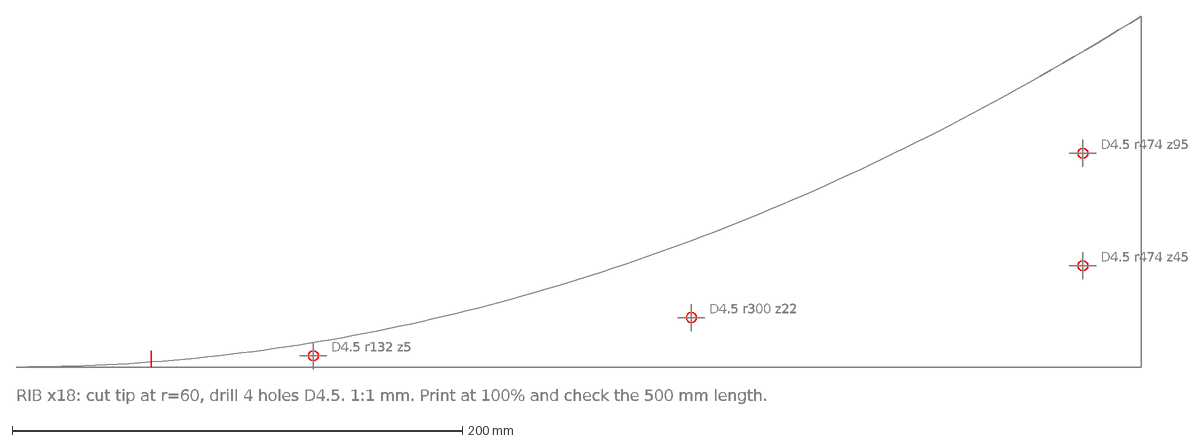
[picture p38: CAD file, 2026-11-12]
drawings/RIB_drilling_template_1to1.dxf
D4.5 r474 z45
D4.5 r474 z95
D4.5 r300 z22
D4.5 r132 z5
RIB x18: cut tip at r=60, drill 4 holes D4.5. 1:1 mm. Print at 100% and check the 500 mm length.
