jahaanb7/RadioTelescope/print/FKC-02.stl

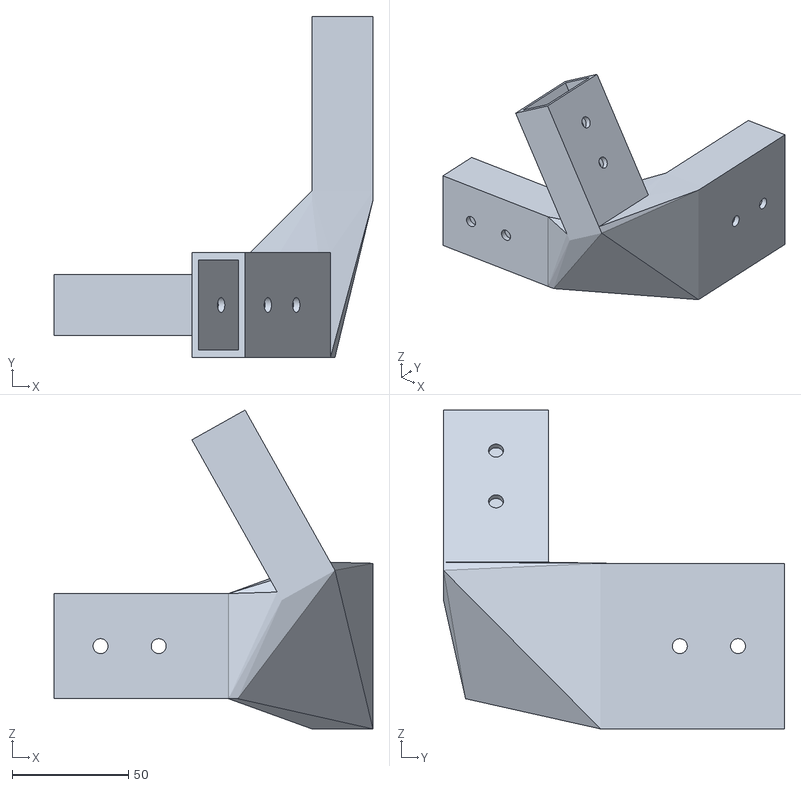
[picture p39: CAD file, 2026-11-12]
print/FKC-02.stl
137.1 x 146.6 x 137.1
