jahaanb7/RadioTelescope/print/EBOX-01.stl

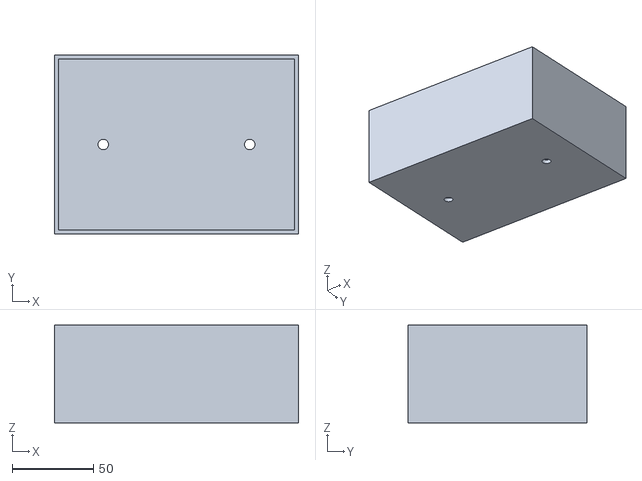
[picture p40: CAD file, 2026-11-12]
print/EBOX-01.stl
150.0 x 110.0 x 60.0
