jahaanb7/RadioTelescope/print/FLA-01.stl

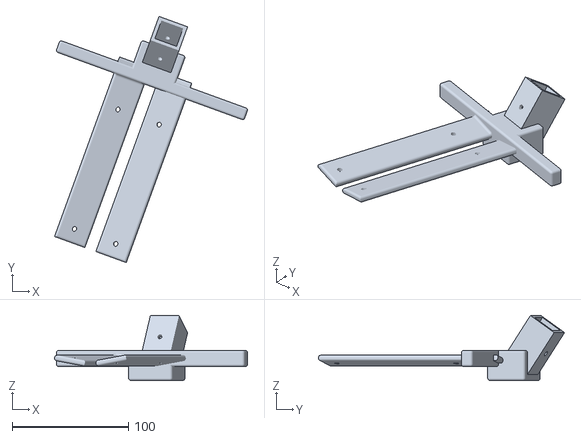
[picture p41: CAD file, 2026-11-12]
print/FLA-01.stl
165.8 x 211.5 x 55.9
