jahaanb7/RadioTelescope/print/SPC-01.stl

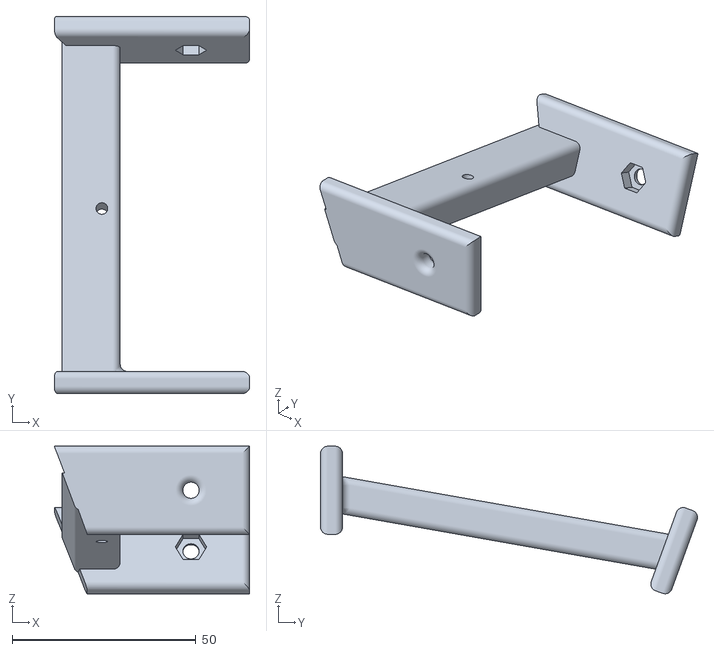
[picture p42: CAD file, 2026-11-12]
print/SPC-01.stl
53.2 x 102.7 x 40.2
