jahaanb7/RadioTelescope/print/RIM-01.stl

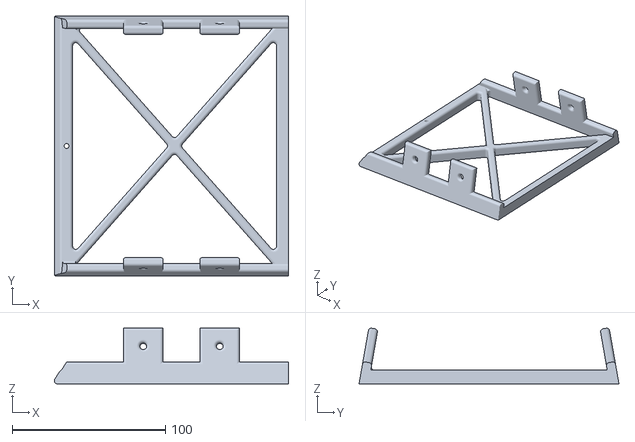
[picture p43: CAD file, 2026-11-12]
print/RIM-01.stl
153.1 x 169.9 x 36.4
