jahaanb7/RadioTelescope/print/JIG-01.stl

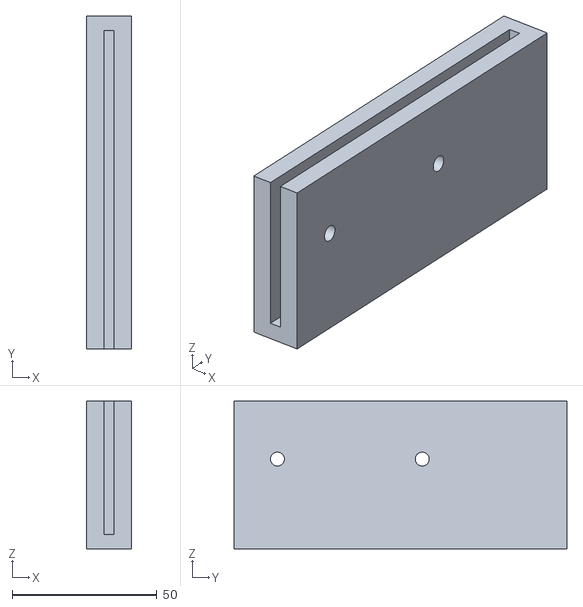
[picture p44: CAD file, 2026-11-12]
print/JIG-01.stl
15.6 x 115.0 x 51.0
