jahaanb7/RadioTelescope/print/HUB-01.stl

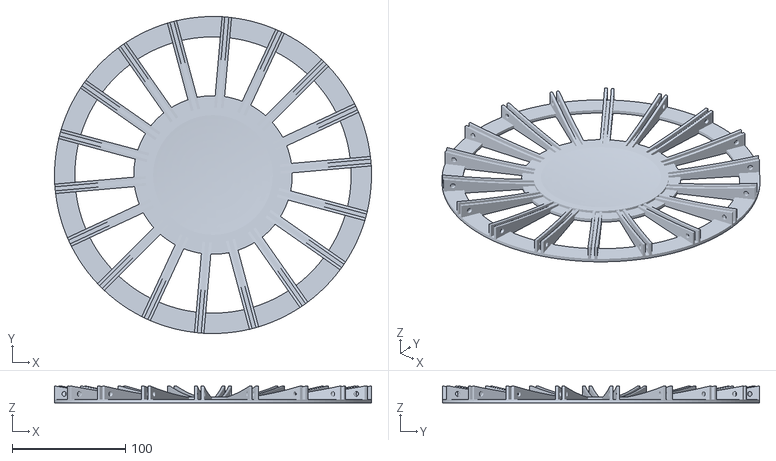
[picture p45: CAD file, 2026-11-12]
print/HUB-01.stl
280.0 x 280.0 x 14.9
