jahaanb7/RadioTelescope/print/JIG-02.stl

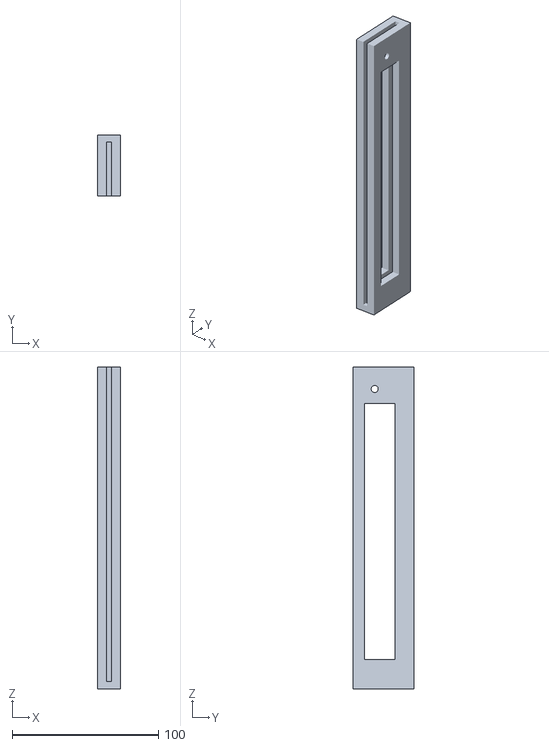
[picture p46: CAD file, 2026-11-12]
print/JIG-02.stl
15.6 x 42.0 x 220.0
