jahaanb7/RadioTelescope/print/FKT-01.stl

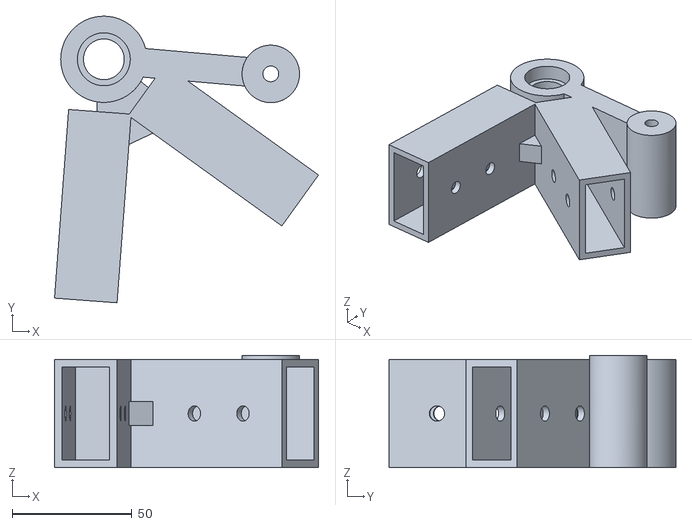
[picture p47: CAD file, 2026-11-12]
print/FKT-01.stl
110.3 x 119.7 x 46.9
