jahaanb7/RadioTelescope/print/FKT-02.stl

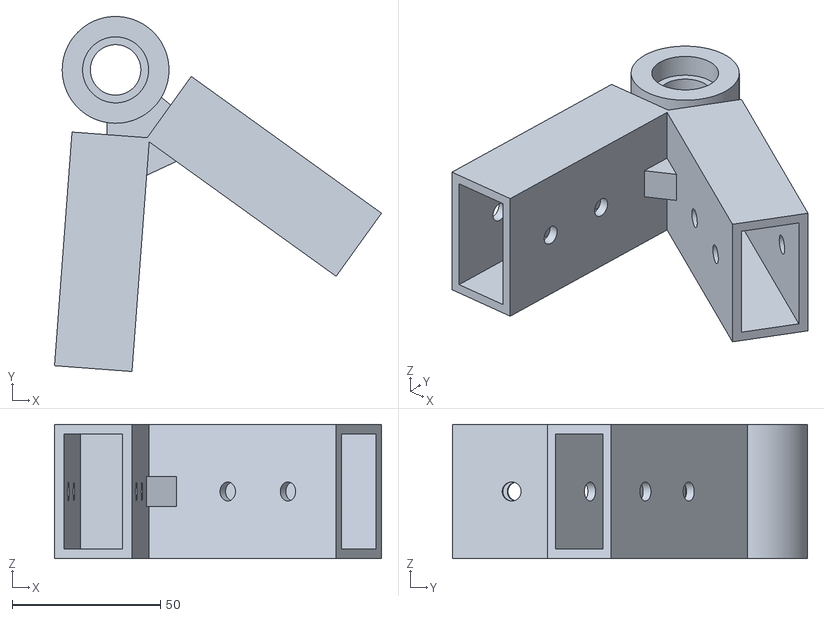
[picture p48: CAD file, 2026-11-12]
print/FKT-02.stl
110.3 x 119.7 x 45.2
