jahaanb7/RadioTelescope/print/RIM-02.stl

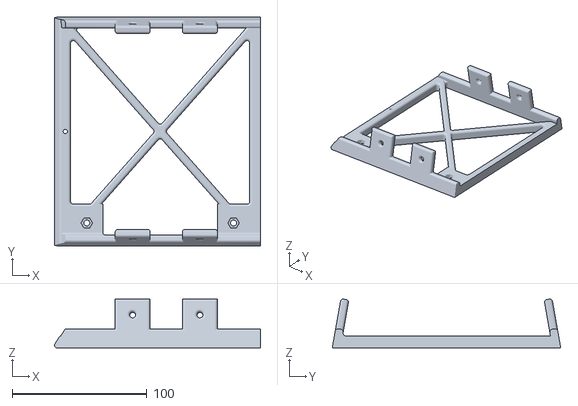
[picture p49: CAD file, 2026-11-12]
print/RIM-02.stl
153.1 x 169.9 x 36.4
