jahaanb7/RadioTelescope/print/RIM-T.stl

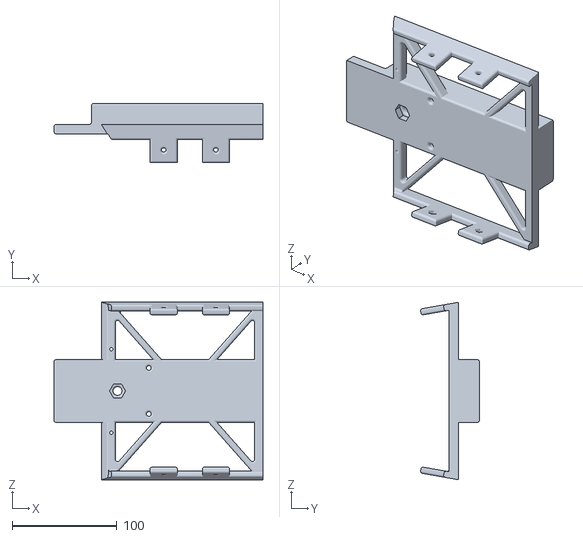
[picture p50: CAD file, 2026-11-12]
print/RIM-T.stl
200.0 x 56.4 x 169.9
