jahaanb7/RadioTelescope/print/EBOX-02.stl

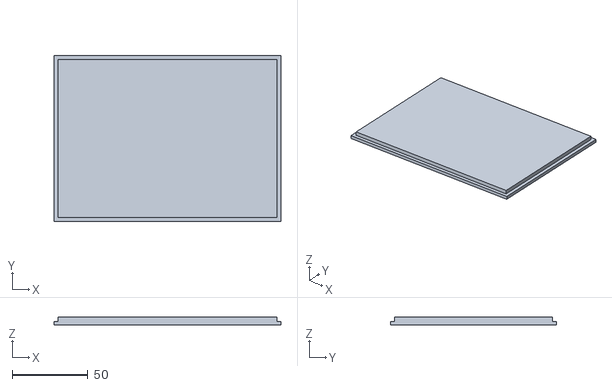
[picture p51: CAD file, 2026-11-12]
print/EBOX-02.stl
150.0 x 110.0 x 5.50
