jahaanb7/RadioTelescope/print/ELS-01.stl

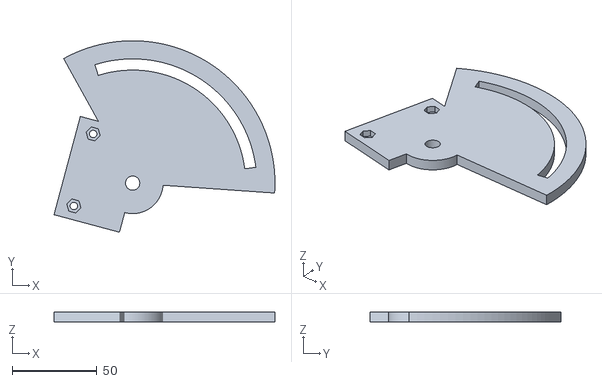
[picture p52: CAD file, 2026-11-12]
print/ELS-01.stl
130.4 x 113.0 x 6.00
