jahaanb7/RadioTelescope/print/LNA-01.stl

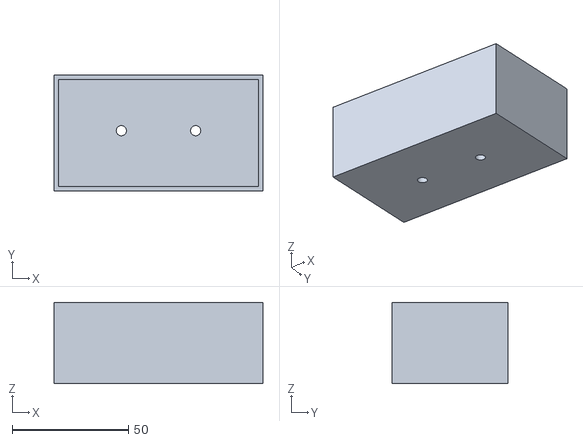
[picture p53: CAD file, 2026-11-10]
print/LNA-01.stl
90.0 x 50.0 x 35.0
