jahaanb7/RadioTelescope/print/FRG-01.stl

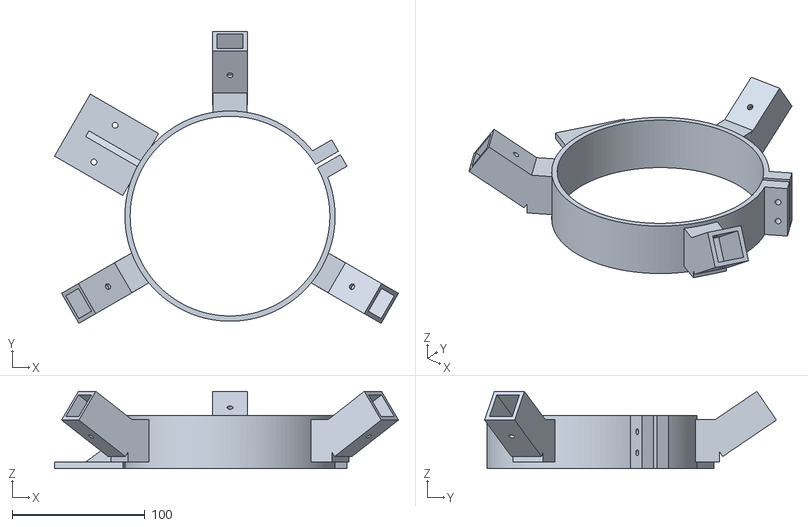
[picture p54: CAD file, 2026-11-10]
print/FRG-01.stl
259.5 x 220.2 x 58.3
