jahaanb7/RadioTelescope/print/KNB-01.stl

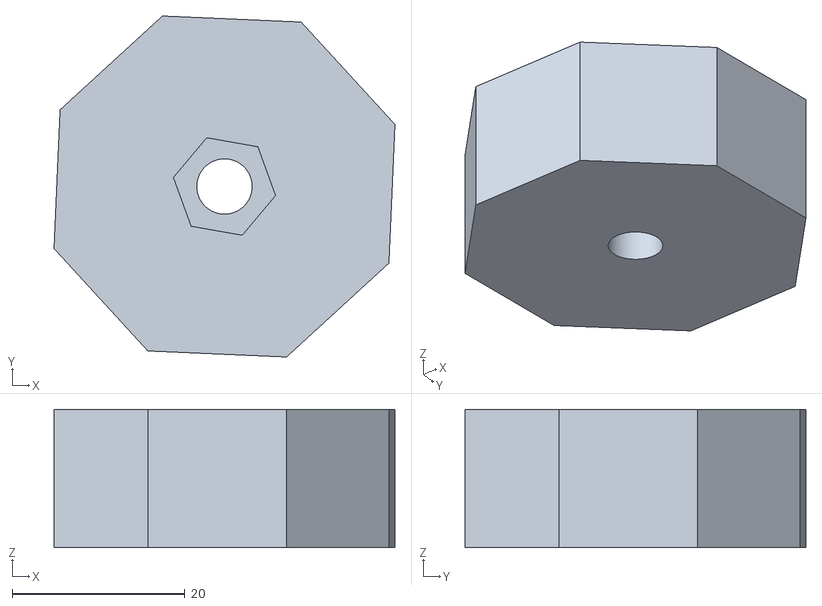
[picture p55: CAD file, 2026-11-10]
print/KNB-01.stl
39.5 x 39.5 x 16.0
