jahaanb7/RadioTelescope/print/LNA-02.stl

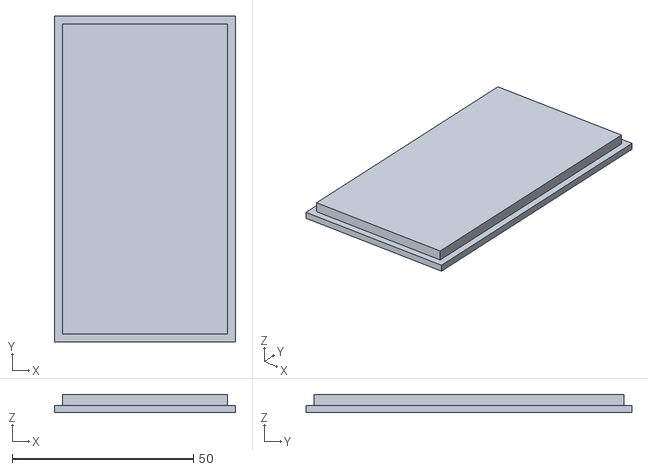
[picture p56: CAD file, 2026-11-10]
print/LNA-02.stl
50.0 x 90.0 x 5.00
