jahaanb7/RadioTelescope/print/FIT-01.stl

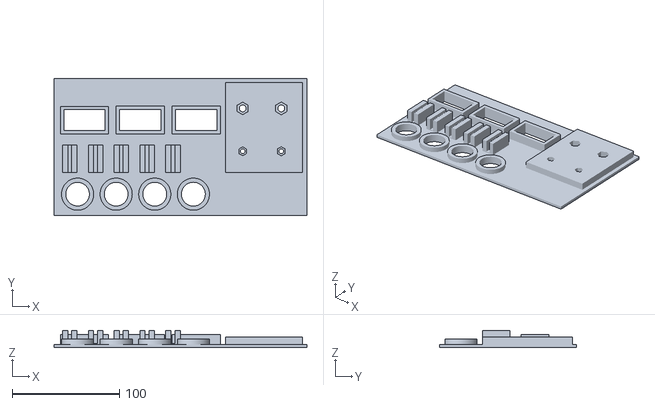
[picture p57: CAD file, 2026-11-10]
print/FIT-01.stl
236.0 x 128.0 x 16.0
