jahaanb7/RadioTelescope/print/SPR-01.stl

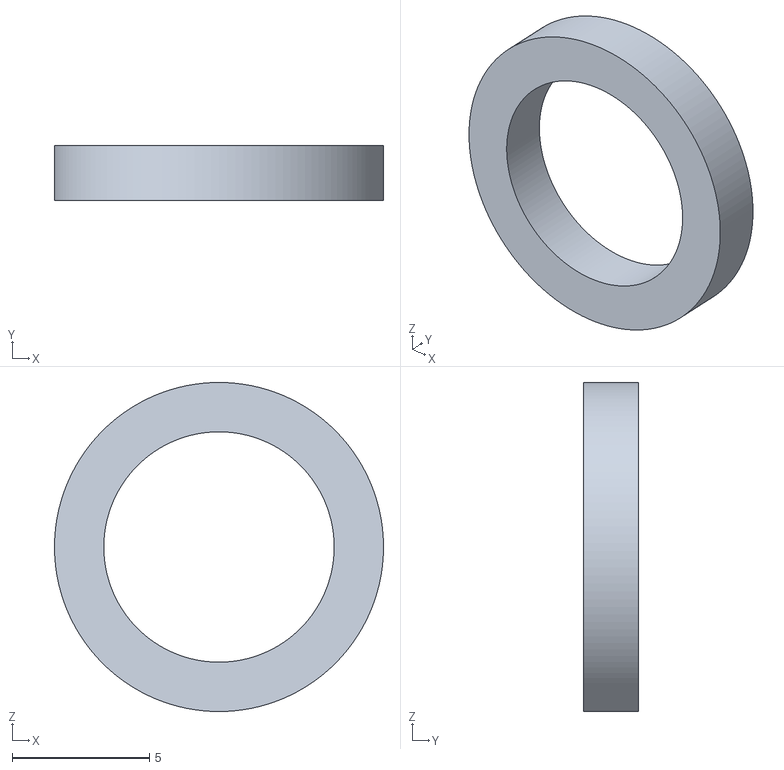
[picture p58: CAD file, 2026-11-10]
print/SPR-01.stl
12.0 x 2.00 x 12.0
