jahaanb7/RadioTelescope/print/SPR-02.stl

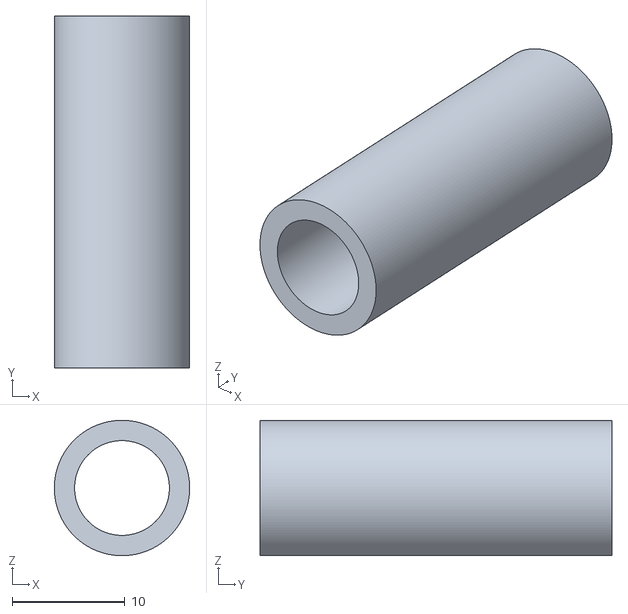
[picture p59: CAD file, 2026-11-10]
print/SPR-02.stl
12.0 x 31.2 x 12.0
