jahaanb7/RadioTelescope/print/SPR-03.stl

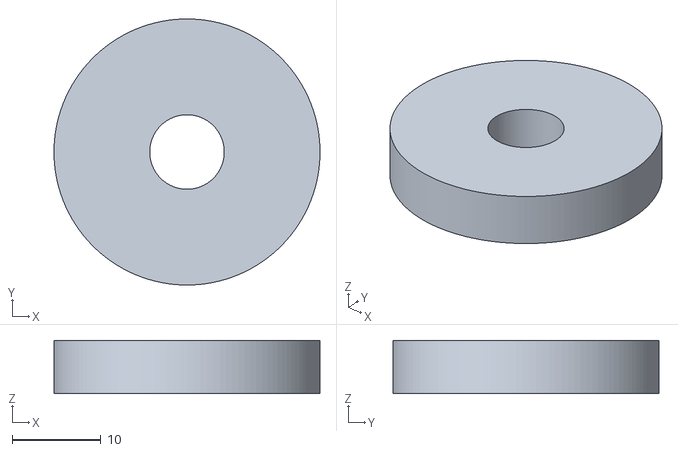
[picture p60: CAD file, 2026-11-10]
print/SPR-03.stl
30.0 x 30.0 x 6.00
