jahaanb7/RadioTelescope/(list of files, cad)

Other CAD files:
print/FKC-01.stl
