jahaanb7/RadioTelescope/analysis/assembly_report.md

# Rev C assembly report

Generated by `cad/build.py`. Modelled and analytically checked; nothing physically tested.
**NOT RELEASED FOR FABRICATION** until the rib thickness, batten sizes are measured and the fit coupon `FIT-01` has been printed.

## Kinematics
- Elevation axle: parallel to Y, 139.2 mm above the dish vertex, 615.2 mm above the ground. Range -5 to 90 deg; the ends of the lock slot are the hard stops.
- Azimuth: no turntable. The base is fixed; point it by turning the whole base on the ground (or on casters).
- Lowest reach of the dish below the axle over the elevation range: 519.0 mm. Clearance to the top of the base: 25 mm.
- Masses: dish 5.95 kg (centre of mass x -0.9, y +2.6, z -0.4 mm from the axle), fixed base 5.00 kg.

## Solids and printability
- 516 solids, 0 invalid.
- Ribs in the assembly: 18 (required 18).
- Every printed and wooden part is one connected solid: yes.
- Printed part types: 20; all fit the 300 x 300 x 330 bed with 5 mm margin: yes.

## Interference checks (solid intersections over 0.5 mm^3)
- Within the dish group (71 solids): 0 interfering pairs.
- Within the az group (17 solids): 0 interfering pairs.
- Every bolt, nut and washer (423 solids) against the parts it passes through: 0 clashes (a clash means a hole or pocket is out of line).

### Elevation sweep: whole dish (with its hardware) against the turning base and fork

| Elevation | Clashes | Lowest point of the dish above the base top |
|---:|---:|---:|
| -5 deg | 0 | 44 mm |
| 0 deg | 0 | 44 mm |
| 5 deg | 0 | 34 mm |
| 10 deg | 0 | 27 mm |
| 15 deg | 0 | 25 mm |
| 20 deg | 0 | 27 mm |
| 25 deg | 0 | 32 mm |
| 30 deg | 0 | 41 mm |
| 35 deg | 0 | 55 mm |
| 40 deg | 0 | 72 mm |
| 45 deg | 0 | 92 mm |
| 50 deg | 0 | 116 mm |
| 55 deg | 0 | 143 mm |
| 60 deg | 0 | 173 mm |
| 65 deg | 0 | 207 mm |
| 70 deg | 0 | 242 mm |
| 75 deg | 0 | 280 mm |
| 80 deg | 0 | 320 mm |
| 85 deg | 0 | 362 mm |
| 90 deg | 0 | 402 mm |

The M8 axle bolts pass through the bearing bores of the fork nodes by design and are excluded.

## Structural checks (only what can fail)

### Wooden members (frame analysis, rigid sockets, pinned feet)

| Load case | Worst member | Axial N | Combined stress | Allowable | Buckling use | Dish movement |
|---|---|---:|---:|---:|---:|---:|
| gravity, zenith, az 0 | LEG-A fork leg x+ y+ | -20 | 0.03 MPa | 10 MPa | 0.4 % | 0.00 mm, 0.0 arcmin |
| gravity + 8 m/s wind, dish at horizon facing the wind, az 0 | LEG-A fork leg x- y+ | -36 | 0.45 MPa | 10 MPa | 0.8 % | 0.00 mm, 2.6 arcmin |
| gravity + 50 N push on the rim along the axle, az 0 | LEG-A fork leg x+ y+ | -29 | 1.07 MPa | 10 MPa | 0.6 % | 0.52 mm, 0.0 arcmin |

Members are 1x2 (19 x 38) fork legs and sills and 1x3 (19 x 64) tie beams. Combined stress = axial + both bending terms at the worst end. Buckling use = compression / Euler load about the weak axis (K = 1). Dish movement is at the axle; the beam is about 15 deg wide, so arcminutes are negligible.

### Socket joints (printed socket, two M6 cross bolts, wooden batten)
- Worst bolt load: LEG-A fork leg x- y+ end i in 'gravity + 8 m/s wind, dish at horizon facing the wind, az 0': axial -36 N, so 18 N per bolt. Wood bearing 0.16 MPa (allowable 8 along the grain); PETG bearing in the two 4 mm socket walls 0.47 MPa (allowable 6 across layers).
- Worst socket moment: LEG-A fork leg x+ y+ end i in 'gravity + 50 N push on the rim along the axle, az 0': 4.7 N m. Taken by contact between batten and socket walls over the 73 mm insertion: wood across the grain 0.21 MPa (allowable 2.5); the same force on the PETG wall is 0.21 MPa (allowable 20).
- Highest joint utilisation over all cases: 8 %.
- Bolt end distance in the wood: 28 mm to the nearer bolt (7 d = 42 mm wanted for full M6 capacity; loads here are far below it).

### Base reactions and stability
- gravity, zenith, az 0: corner reactions 21 to 38 N (a negative value means that corner lifts).
- gravity + 8 m/s wind, dish at horizon facing the wind, az 0: corner reactions 9 to 40 N (a negative value means that corner lifts).
- gravity + 50 N push on the rim along the axle, az 0: corner reactions 7 to 51 N (a negative value means that corner lifts).
- Total mass 10.9 kg. Axle 615 mm above the ground. The base stands on four corners, 650 mm apart along the pointing direction and 1085 mm along the axle, so the tipping lever is 325 mm (wind along the pointing direction, the worst case).

| Wind | Drag (solid disc, Cd 1.2) | Overturning | Resisting, no ballast | Ratio | Ballast per upwind corner for ratio 1.5 |
|---:|---:|---:|---:|---:|---:|
| 5 m/s | 14 N | 8.9 N m | 34.9 N m | 3.93 | 0.0 kg |
| 8 m/s | 37 N | 22.7 N m | 34.9 N m | 1.54 | 0.0 kg |
| 10 m/s | 58 N | 35.5 N m | 34.9 N m | 0.98 | 1.4 kg |
| 12 m/s | 83 N | 51.1 N m | 34.9 N m | 0.68 | 3.3 kg |
| 15 m/s | 130 N | 79.9 N m | 34.9 N m | 0.44 | 6.7 kg |

Ballast is a sandbag or water jug laid over each end of the tie beams. The wind can come from either side, so put the same ballast on all four corners.

### Elevation axle, bearings and lock
- Dish 5.95 kg, centre of mass 1.0 mm from the axle (x -0.9, z -0.4).
- Per side: 29 N weight plus 18 N wind at 8 m/s = 35 N. Two 608 bearings share it: 17 N each against a static rating of 1370 N.
- M8 axle bending at the bearing (31 mm lever): 1.06 N m, 40 MPa against 640 MPa.
- PETG under the bearing outer races: 0.11 MPa (sustained across layers allowable 4; housing is printed with the bore vertical, so the load is in the layer plane, allowable 10).
- Axle bearing on the trunnion block, 8 mm bolt in 20 mm of PETG: 0.22 MPa (allowable 10 sustained).
- Lock: worst torque on the axle = imbalance 0.06 N m + wind with the centre of pressure 0.1 D off axis 3.69 N m = 3.75 N m. Friction on two faces (mu 0.3) at 70 mm needs 89 N of clamp. A hand-tight M6 knob gives 1000-2000 N. Washer pressure on the sector at 1500 N: 19.0 MPa (compression allowable 20).

### Dish joints and feed support
- Rim joint: whole dish weight shared by 36 M4 bolts gives 1.6 N per bolt; bearing in the 3.17 mm rib 0.13 MPa (plywood allowable 15). The joint is clamped, so friction carries it before the bolt bears.
- Feed head 0.75 kg on three 19 mm square legs, 504 mm between socket starts: worst leg force with a 20 N knock 24 N; Euler load 4016 N (1 % used). One M4 per leg end: 0.32 MPa wood bearing.
- Feed movement: leg stretch is under 0.01 mm. Joint clearance (0.8 mm in the sockets) lets the feed shift up to about 0.5 mm, against a focus tolerance of about lambda/10 = 21 mm.

### Not checked, and why
- Rim girder, hub, spacers: they carry under 70 N in total; their sizes are set by printing and handling, not stress.
- Fatigue, temperature: the telescope is moved by hand a few times per session; PETG softens near 70 C, so do not leave it in full summer sun for hours.
- Wood moisture: sockets have 0.8 mm clearance so swelling does not split them; seal batten ends.

## Exports
- `exports/telescope_revC_az0_el45.step`: nested assembly (base / dish), 516 solids. `exports/stages/*.step`: the two stages at el 90 for Fusion.
- `print/`: 23 STLs laid flat for the bed, `print/print_list.csv`. PETG estimate 5.05 kg including the coupon and jigs.
- `bom/`: bom.csv (28 part types), hardware.csv (423 fasteners and bearings), cut_list.csv (11 battens, 6.9 m of stock before saw kerf), rib_modifications.csv.
- `drawings/RIB_drilling_template_1to1.dxf`: rib cut and drill template, 1:1.
- `images/`: assembly, motion-range and build-stage renders; `images/parts/`: one image per part type.
- `print/print_specs.csv`: bed orientation, supports, settings and estimated time per part (cad/print_prep.py).
- `cad/fusion/telescope_joints/`: Fusion 360 script that imports the two stages and adds the elevation joint. Export time 936 s.
