jahaanb7/RadioTelescope/docs/assembly_guide.md

# Assembly guide: Rev C.2 1 m hydrogen-line radio telescope

Part numbers (for example `RIM-01`) match the files in `print/`, `exports/parts/`, `images/parts/` and the lists
in `bom/`. All bolts are hex-head grade 8.8 with a washer under the head and under the nut unless stated.
"Snug" means tight by hand with a short spanner: PETG creeps if you crush it.

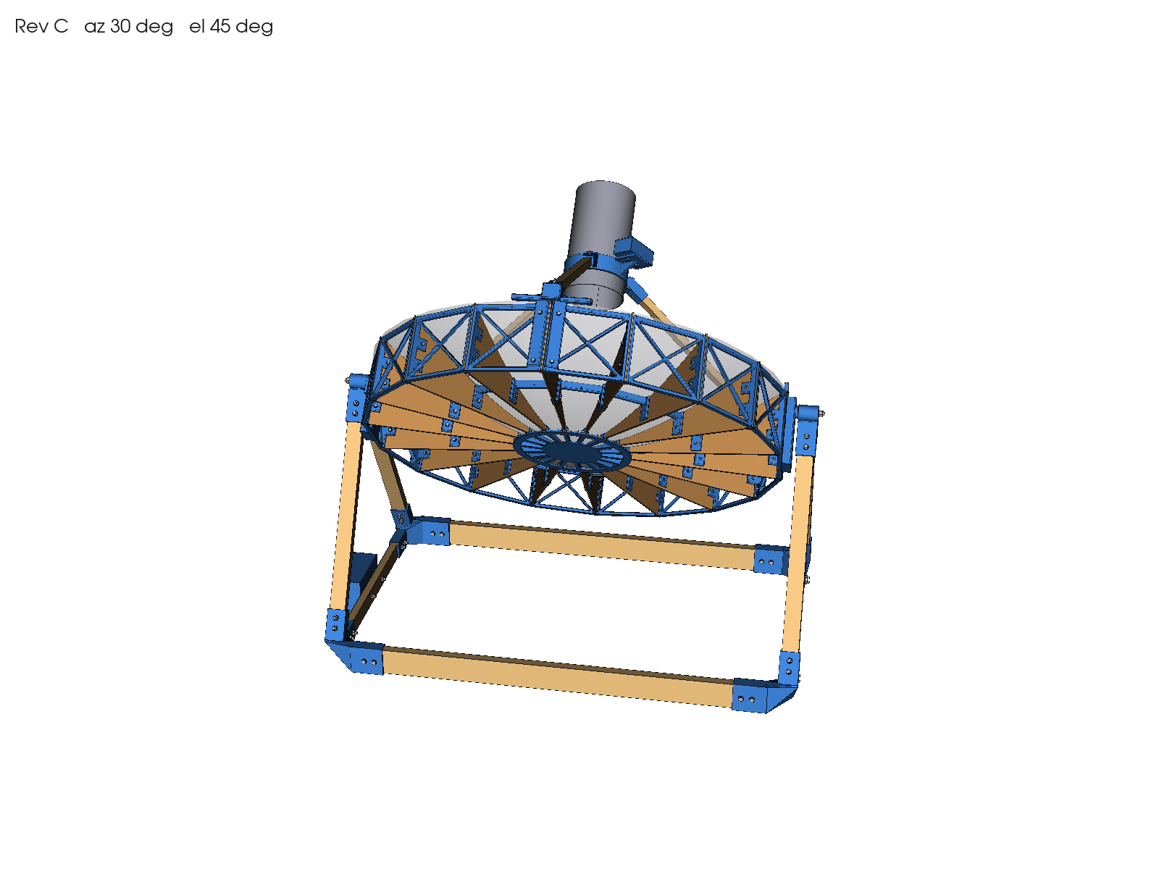
[picture p61: images/assembly_iso_el45.png]
Finished telescope


> This guide describes the supplied Rev C.2 model. The design is not released for fabrication; follow the [input register](inputs_and_assumptions.md) and record checks in the [inspection checklist](inspection.md). STEP files mentioned here are generated by the full build.

## 0. Before you start

1. **Measure** the rib board and the battens (see [inputs_and_assumptions.md](inputs_and_assumptions.md)). If
   any differ from `cad/parameters.yaml`, change the value and run `python3 cad/build.py` to regenerate every file.
2. **Print `FIT-01` first** with the filament and settings you will use. Check, left to right:
   - 608 bores (22.00 / 22.10 / 22.20 / 22.25): the bearing should press into one bore with a vice and slide into a
     looser one by hand. Set `tolerances.bearing_bore_fixed` and `bearing_bore_float` to those values.
   - Rib slots (rib + 0.2 … + 0.6): pick the narrowest that a rib slides into without forcing. Set `rib_slot_total`.
   - Batten sockets (+0.6 / +0.8 / +1.0): pick the one that takes a 1x2 with light hand pressure. Set `batten_socket`.
   - Nut pockets (+0.2 / +0.4 for M4 and M6): the nut should press in and stay. Set `nut_pocket_af`.
   Rebuild after changing anything.
3. **Print everything** in `print/` (see [printing.md](printing.md)). Press nuts into their hex pockets as you go,
   warming them with a soldering iron if they are tight.
4. **Cut the battens** from `bom/cut_list.csv`: square ends, lengths exact. Drill the cross-bolt holes at the
   distances given, measured from each end, through the thin face and centred on the wide face. Seal the ends.

Tools: drill with 2.5, 4.5 and 6.5 mm bits, saw and mitre box, 7, 10 and 13 mm spanners, calipers, square,
spirit level, vice, soldering iron (for nuts), zip ties.

## 1. Rib preparation (all 18 ribs)

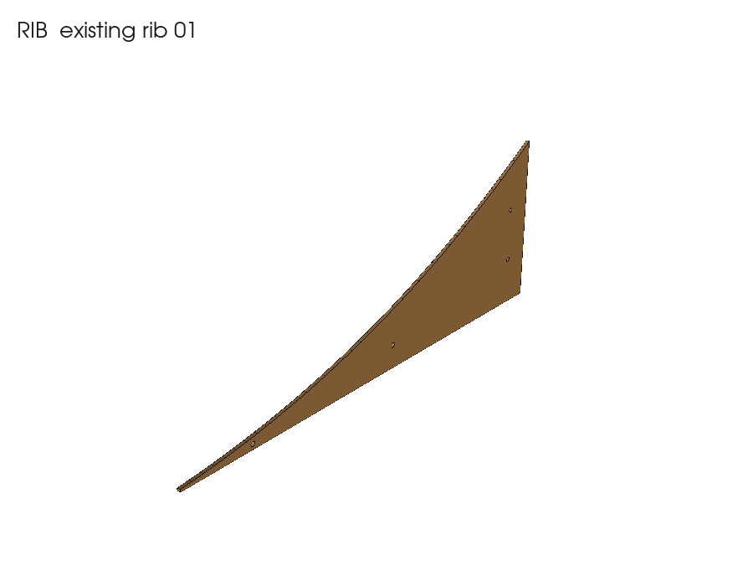
[picture p62: images/parts/RIB.png]
Rib template


1. Cut the **60 mm tip relief** at the pointed end: a square cut 60 mm from the tip (template:
   `drawings/RIB_drilling_template_1to1.dxf`, print at 100 % and check the 500 mm length).
2. Drill the two **rim holes** (4.5 mm, r = 474 mm) with **`JIG-01`** and the **mid-span hole** (r = 300 mm) with
   **`JIG-02`**: slide the jig over the rib end, push it home and drill through the guide holes. Positions are in
   `bom/rib_modifications.csv`.
3. The **tip pin hole** (r = 132 mm) is drilled later, through the hub, with the rib in place (step 3a).

## 2. Stage 1: base and fork

Base and fork

The base is a rectangle on four printed corner nodes, which are also the feet: two **`TIE-01`** tie beams (19 × 64)
run along the axle (Y) under the dish, two **`SIL-01`** sills (19 × 38) run across (X), and four **`LEG-A`** fork
legs (19 × 38) rise from the corners to the two fork top nodes. Every socket takes two **M6 × 40** cross bolts
with washers and nuts. Snug.

1. Press two **608 bearings** into each fork top node: **`FKT-01`** (+Y side, tight fit, has the lock lug) and
   **`FKT-02`** (−Y side, sliding fit so the axle can float). Press with a vice on the outer race only.
2. On the floor, push the sills and tie beams into the four corner nodes **`FKC-01`** / **`FKC-02`** (FKC-01 at
   x+y+ and x−y−, FKC-02 at x+y− and x−y+) and bolt them. Check the rectangle is square by measuring both diagonals.
3. Fit the four fork legs from the corner nodes up to `FKT-01` and `FKT-02` and bolt them. Sight through both
   bearing bores to check they line up.
4. Bolt **`EBOX-01`** to the +Y sill with two **M6 × 35**.
5. Set the base on firm, level ground. It stands on its four corner nodes; shim a corner if it rocks.

## 3. Stage 2: dish

Work on a large flat table with the dish face up (vertex down).

### 3a. Ribs and hub

Ribs in the hub

1. Put **`HUB-01`** on the table, channels up. The hub floor sits 3 mm below the flat back edges of the ribs, so
   put the rib ends on 3 mm scrap (card or hardboard).
2. Stand the 18 ribs in the 18 channels, flat edge down, pointed end toward the centre.
3. Drill each rib tip through the two channel-wall holes (4.5 mm, with the rib pushed fully home), then fit an
   **M4 × 20** pin, washer and nut. Snug. The pins sit below the reflector surface, so nothing touches the mesh.

### 3b. Rim girder, spacers and trunnions

Dish frame

1. Fit the 18 rim bays between the rib ends: ten **`RIM-01`** (plain front), six **`RIM-02`** (front pads for
   the feed anchors) and two **`RIM-T`** trunnion bays. The two `RIM-T` must be opposite each other, centred between ribs,
   on the axle line (Y). The six `RIM-02` go on both sides of ribs 60°, 180° and 300°, pads toward that rib.
   Press an M4 nut into each of the two pad pockets on every `RIM-02`. Each rib end sits between the flanges of
   two neighbouring bays.
2. Bolt the bays on: at each rib end, push two **M4 × 20** side bolts through flange, rib and flange (the two
   rim holes), into the nuts in the flange pockets. Check that the rib tops sit flush with the bay tops, then snug.
3. Fit the 18 **`SPC-01`** spacers between the ribs at mid span (r = 300 mm), one **M4 × 20** side bolt per rib.
4. Bolt the lock sector **`ELS-01`** to the +Y trunnion with two **M4 × 35** (nuts in the sector pockets) and put
   spacer **`SPR-03`** on the −Y trunnion.
5. Drop an **M8 × 90** bolt into the hex pocket inside each trunnion, thread pointing outward.

### 3c. Feed support, feed and mesh

Complete dish

1. Bolt the three feed-leg anchors **`FLA-01`** to the rim at ribs 60°, 180° and 300° (four M4 × 20 each,
   into the nuts in the pads of the neighbouring `RIM-02` bays).
2. Push the three **`LEG-F`** feed legs (19 × 19) into the anchors and into **`FRG-01`** (feed collar), one
   **M4 × 35** at each end.
3. Slide the **feed can** into the collar, open end toward the dish. The CAD places its open end at the nominal focus,
   **400.6 mm above the dish vertex**. This is a starting position; the feed phase centre and RF performance still need validation. Clamp it with the two **M4 × 30** pinch bolts. It can slide later for
   focusing.
4. Bolt **`LNA-01`** to the collar shelf (two M4 × 12), fit the LNA and close with **`LNA-02`**.
5. **Mesh**: cut 18 gores (one per bay) from the mesh with about 15 mm overlap. Lay each gore on the rib top edges,
   and fasten along the ribs. The mesh fastening is not modelled; the recommended method is small zip ties or
   stainless wire through 2.5 mm holes drilled 5 mm below each rib top edge every 100 mm, plus the zip-tie hole
   in each rim bay and spacer. Keep the mesh taut and on the rib edges; ripples up to about 5 mm are acceptable at 21 cm.

## 4. Stage 3: dish into the fork (two people)

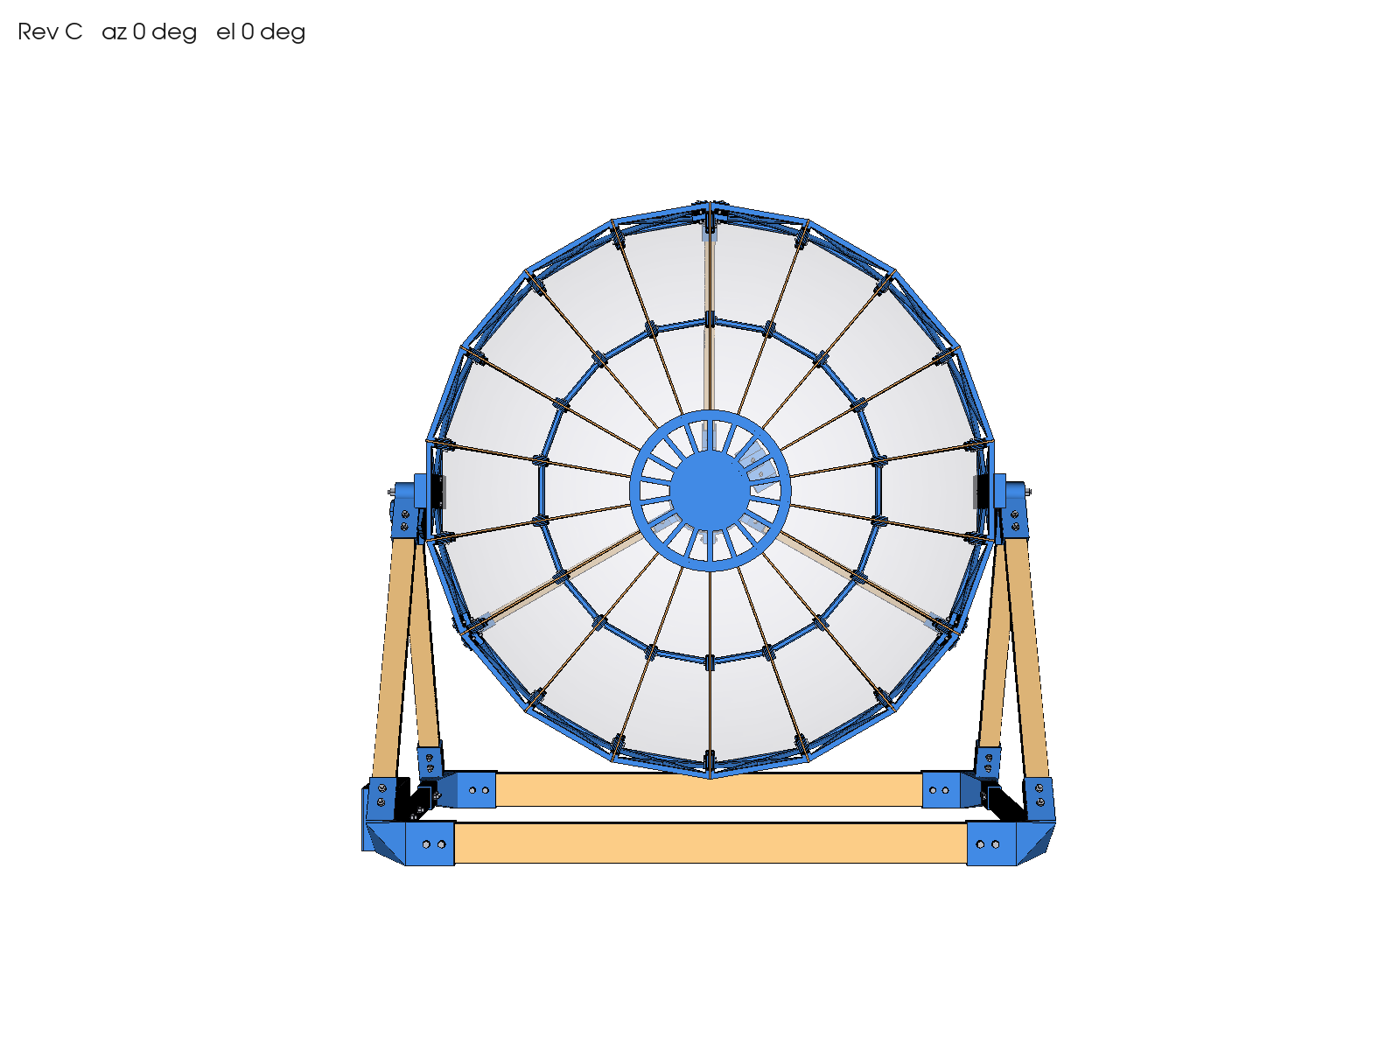
[picture p63: images/assembly_side_el0.png]
Side view, elevation 0


1. Push the **M6 × 70 carriage bolt** through the slot of `ELS-01` from the dish side, so its head sits behind the
   sector and its square neck engages the slot.
2. With the dish face sideways (elevation 0), lower it between the fork top nodes. The carriage bolt goes through
   the hole in the `FKT-01` lock lug.
3. Push each M8 axle bolt outward through: trunnion, `ELS-01` (+Y) or `SPR-03` (−Y), **`SPR-01`**, the first
   bearing, **`SPR-02`**, the second bearing, an **M8 washer** and the **M8 nyloc nut**. Tighten until the inner
   races are clamped and the dish still swings freely.
4. On the lock: M6 washer, then **`KNB-01`** (with its captured M6 nut). Hand-tight locks the elevation; the ends of
   the slot are the hard stops at −5° and 90°.

## 5. Check and commission

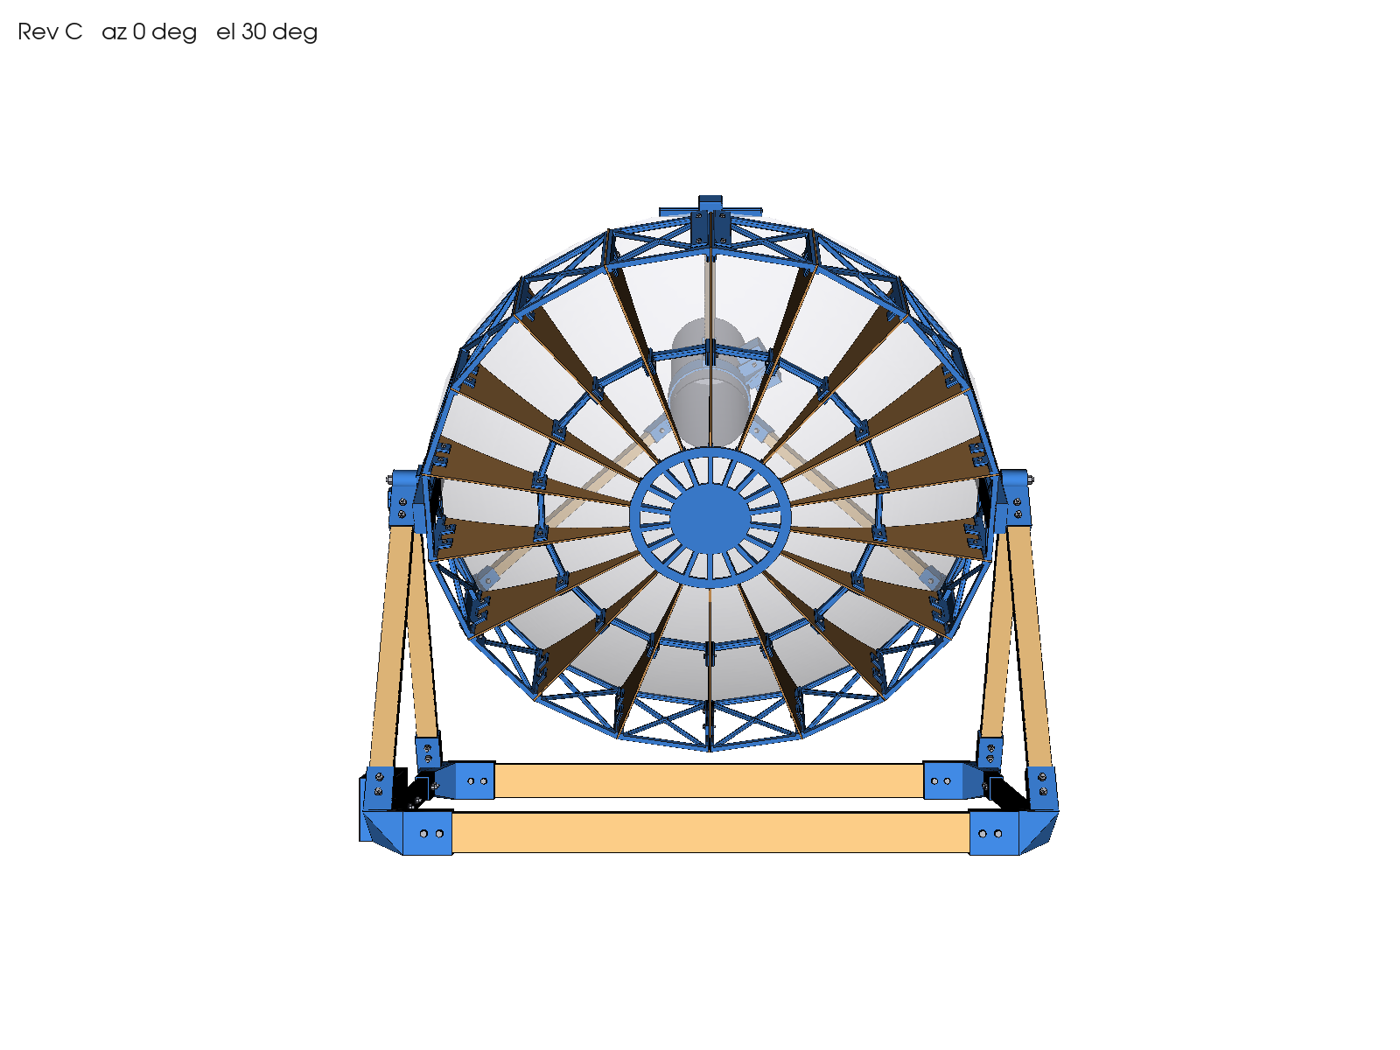
[picture p64: images/motion_el30.png]
Motion range


1. Release the lock. Support the dish while releasing the lock. The model predicts its centre of mass about 1 mm from the
   axle, but actual balance must be checked. If it drifts, slide the feed can a few mm or tape a small weight to the light side of the rim.
2. Swing the dish through its full range. Nothing should touch; the closest approach is about 25 mm at 15°
   elevation. To point in azimuth, lift and turn the whole base.
3. Outdoors, lay ballast (sandbags or water jugs) over the four ends of the tie beams: the saved model estimates an unballasted tipping threshold near
   8 m/s and ballast of 1.4 kg per corner for 10 m/s or 3.3 kg for 12 m/s. These are analytical estimates, not validated operating limits. Do not leave it out unattended in stronger wind.
4. Route the coax from the LNA down one feed leg, along the rim and down a fork leg to `EBOX-01`, with a loop at the
   axle so the dish can swing.

## Part reference

All part images are in [`images/parts/`](../images/parts/). Quantities, masses and suppliers are in
[`bom/`](../bom/) and [shopping_list.md](shopping_list.md).
