jahaanb7/RadioTelescope/images/assembly_front_el45.png

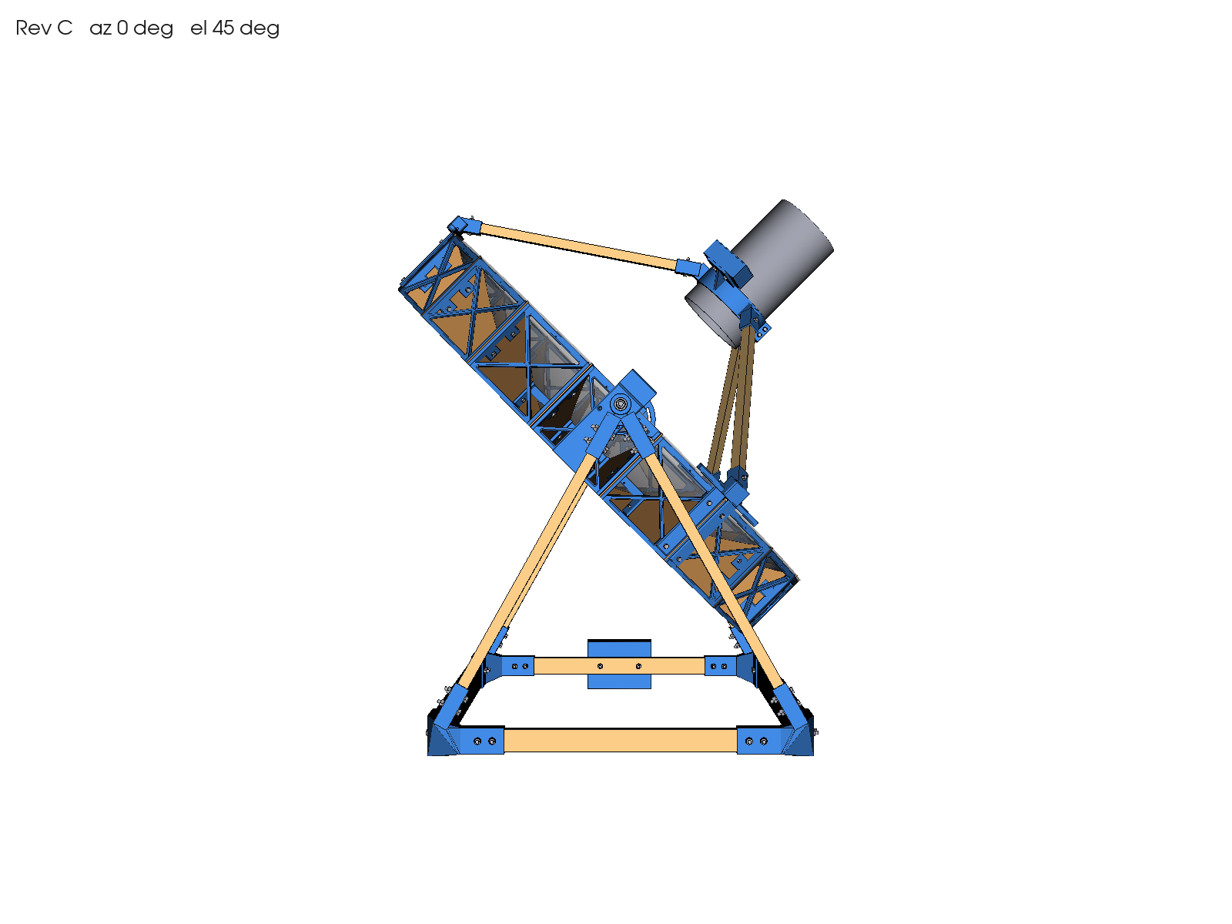
images/assembly_front_el45.png
