jahaanb7/RadioTelescope/images/assembly_iso_zenith.png

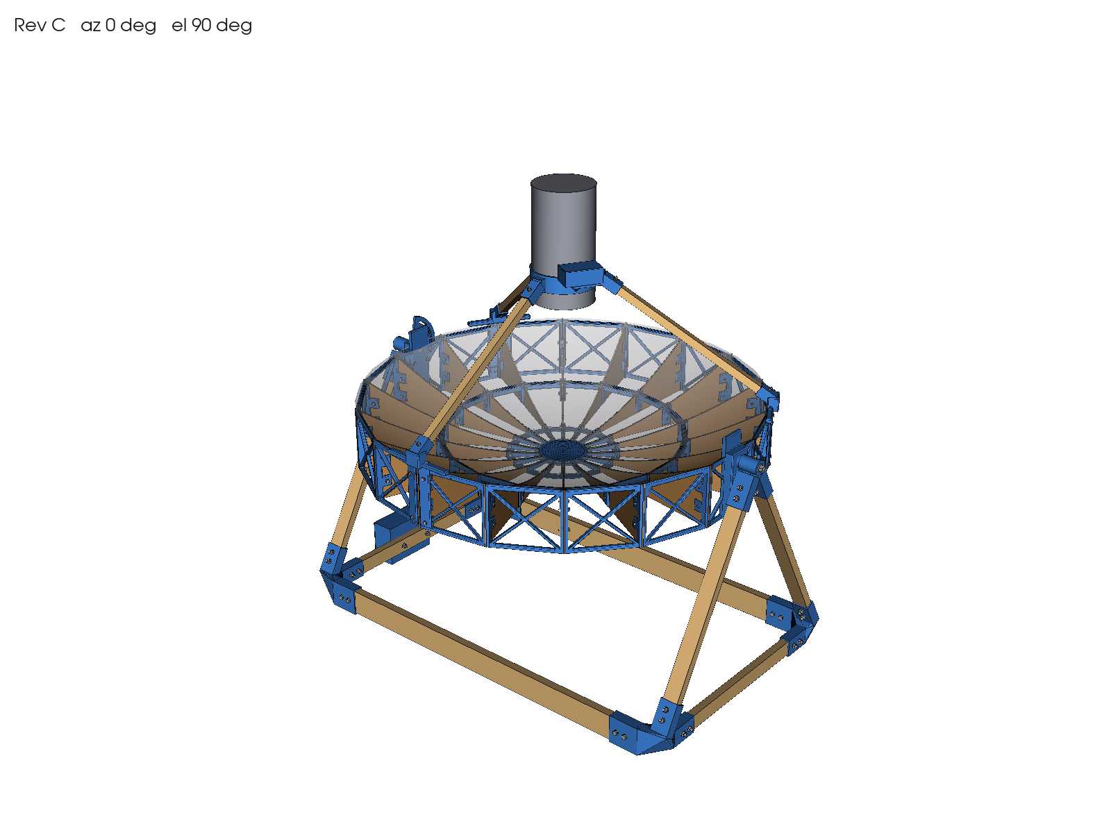
images/assembly_iso_zenith.png
