jahaanb7/RadioTelescope/images/assembly_rear_el20.png

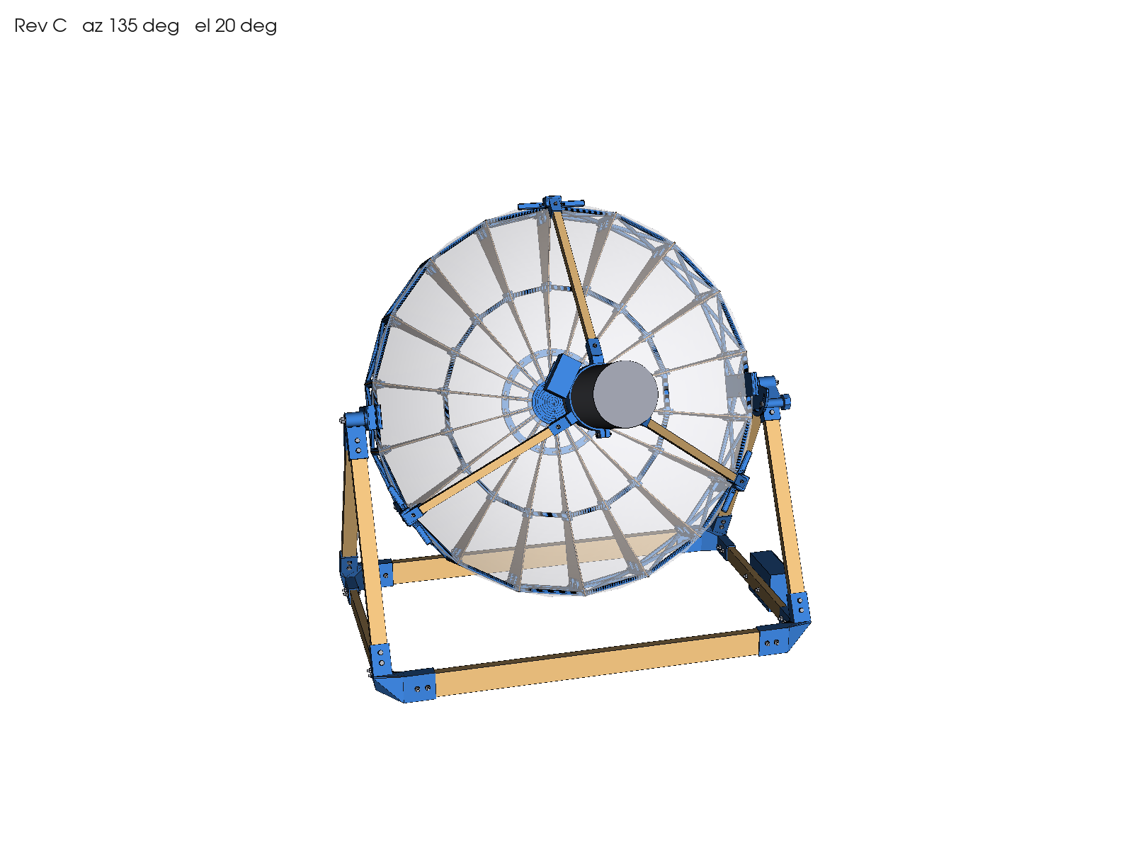
images/assembly_rear_el20.png
