jahaanb7/RadioTelescope/images/assembly_top_zenith.png

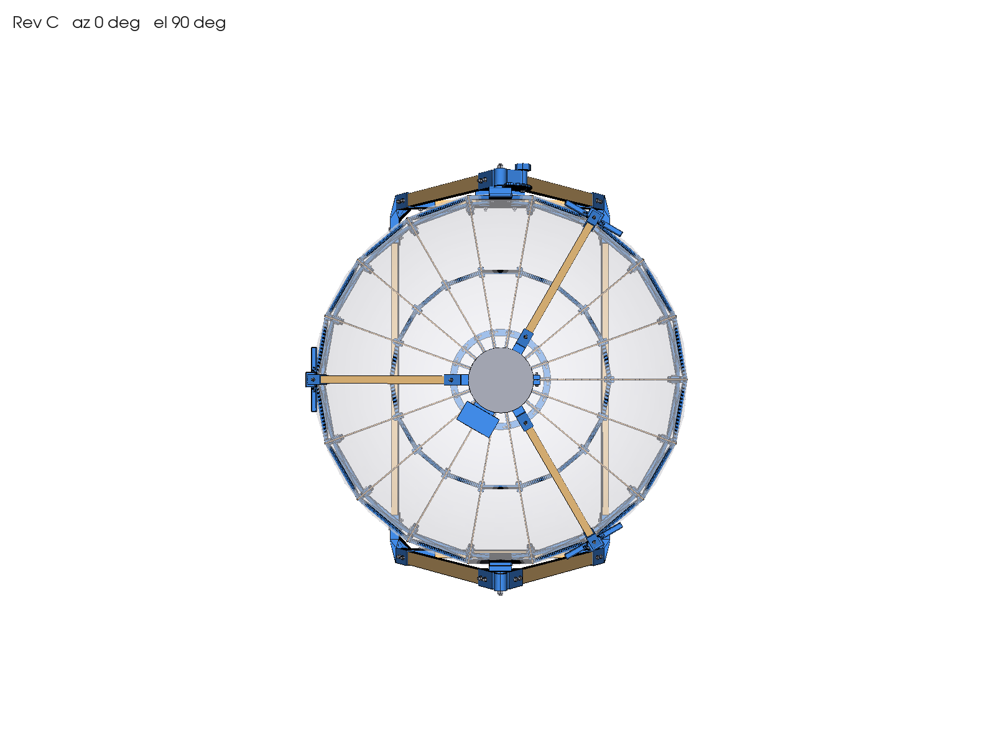
images/assembly_top_zenith.png
