jahaanb7/RadioTelescope/(commit log)

2026-11-10 Add provisional 1 m hydrogen-line radio telescope design package (Rev B)
    Parametric CadQuery source, 186-solid assembly STEP, per-part STEP files,
    printable STLs, plywood DXF outlines, hidden-line views, provisional BOM
    and analysis reports. Stage 3 of 6; nothing is released for fabrication.
    [BAT-01.step, BAT-02.step, CAP-01.step, CAP-01_PROVISIONAL.stl, COL-01.step, COL-01_PROVISIONAL.stl, EBOX-01.step, FEED-01.step]
2026-11-10 Rev C: minimum-wood printed design with working azimuth and elevation joints
    - New generator cad/build.py replaces cad/build_assembly.py: 18 existing ribs,
    softwood battens in printed sockets, 24 PETG part types sized for a Prusa
    CORE One L, every bolt, nut, washer and pocket modelled.
    - Three kinematic stages (fixed stand, turning base, dish): lazy-susan azimuth
    bearing with M10 kingpin, 608-bearing elevation axle, lock sector with hard
    stops at -5 and 90 deg.
    - Checks: 601 solids valid, single-solid parts, bed fit, 0 clashes for parts,
    fasteners, elevation and azimuth sweeps; 3D frame analysis, joints,
    bearings, kingpin, lock clamp, tipping and ballast.
    - Exports: nested STEP a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
    [AZB-01.step, AZB-01.stl, AZT-01.step, AZT-01.stl, BAT-01.step, BAT-02.step, CAP-01.step, CAP-01_PROVISIONAL.stl]
2026-11-10 WIP: 1/8 in ribs, flat-top keeper, print prep, images, build docs
    - Rib thickness set to 1/8 in (3.175 mm); all rib slots, flanges, jigs and
    the fit coupon follow it. Checks passed on the full run at this thickness.
    - HUB-02 keeper ring given a flat top so it prints without supports.
    - cad/print_prep.py: picks bed orientation, flags supports, estimates
    filament and print time, writes print/print_specs.csv.
    - New docs: docs/assembly_guide.md, docs/shopping_list.md.
    - images/: assembly renders and per-part images (partial; the last rebuild
    was stopped during rendering).
    - BOM naming fixes; rib audit outputs in rib_audit folders.
    Work in progress: the rebuild was stopped before print_pre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
    [AZB-01.step, AZT-01.step, EBOX-01.step, EBOX-02.step, ELS-01.step, ELS-01.stl, FIT-01.step, FIT-01.stl]
2026-11-10 Finish Rev C build package: oriented STLs, print specs, images, printing guide
    [AZB-01.step, AZB-01.stl, AZT-01.step, AZT-01.stl, EBOX-01.step, EBOX-01.stl, EBOX-02.step, EBOX-02.stl]
2026-11-12 Reorganize telescope build repository
    [AZB-01.step, AZT-01.step, EBOX-01.step, EBOX-02.step, ELS-01.step, FIT-01.step, FKC-01.step, FKC-02.step]
2026-11-12 Update to uploaded Rev C.2 CAD and illustrated build documentation
    [AZB-01.stl, AZT-01.stl, EBOX-01.stl, EBOX-02.stl, ELS-01.stl, FKC-01.stl, FKC-02.stl, FKT-01.stl]
2026-11-12 Polish project README and add itemized CAD build budget with price sources
2026-11-12 Add experimental quarter-turn rib joints with CAD coupons and geometry checks
    [coupon.step, far_flange.stl, near_flange.stl, quarter_turn_lock.stl]
2026-11-12 Revert "Add experimental quarter-turn rib joints with CAD coupons and geometry checks"
    Restores the repository contents before ac0bd67d5b07ef979c77d17b71d92301d30253b6.
    [coupon.step, far_flange.stl, near_flange.stl, quarter_turn_lock.stl]
